Maradosx/smart-home-aiot/PROJECT_STATUS_REPORT.md

# 📊 Smart Home AIoT — Final Status Report (POST-DEFENSE)

> **Last Updated**: 26 พ.ค. 2569 evening
> **Project**: บ้านอัจฉริยะ — CE08, Bangkok University
> **Defense Date**: 26 พ.ค. 2569 — ✅ **PASSED "ไปได้ด้วยดี"** 🎓

---

## 🎯 Overall Status: ✅ **PRODUCTION-READY + DEFENSE PASSED**

| Phase | Status |
|---|---|
| Hardware (5 ESP32 + 6 Zigbee + Pi) | ✅ 100% — All publishing live |
| Cloud (HA + n8n bypassed + MQTT + Lambda EXPERT) | ✅ 100% — All endpoints alive |
| AI Agent (ChAvee ngrok + Alexa EXPERT shared brain) | ✅ 100% — Claude Haiku 4.5 with full context |
| LINE Bot ChAvee | ✅ 100% — ngrok bypass: chat + control + AI reasoning |
| Alexa Voice EXPERT mode | ✅ 100% — All 24 new automations known |
| Mobile Push (3-channel) | ✅ 100% — Resilient fan-out |
| Smart Lighting (4 rooms) | ✅ 100% — PIR/mmWave + LDR per-room thresholds |
| Pump auto + Scene system | ✅ 100% — State-based + 8 smooth scenes |
| Documentation | ✅ 100% — Updated POST-DEFENSE (V4_FIX_LOG +Part2, POST_DEFENSE_FINAL) |
| Testing | ✅ Core verified during defense demo |
| Bug fix journey | ✅ V4_FIX_LOG.md (450 lines: PART 1 v4 HOTFIX + PART 2 26 พ.ค. sprint) |
| Defense Slides | 🔒 User reserved |

---

## 🏆 Coolness Score: **10/10**

### What makes it stand out:
- **3-layer resilient architecture** (Edge ↔ Cloud ↔ UI)
- **Shared AI brain** — LINE Bot ชาวี + Alexa ใช้ Claude Haiku 4.5 ตัวเดียวกัน
- **Multi-modal UI**: LINE bot (TH) + Alexa (EN) + HA Dashboard + Auto sensors
- **Self-healing**: webhook guard ทุก 15 วินาที, retained MQTT, fuzzy ASR matching
- **Behavior analytics** via Supabase chat_logs + mode_changes
- **Real-world value**: fall detect (LD2410), gas/smoke (MQ-2), leak (SNZB-05P), intrusion
- **ASR resilience** — fuzzy_room map "kitchen → chicken/kitten" automatically
- **Defense-ready storytelling** — 3-sentence pitch + 12-command 5-min demo

---

## 📋 Final Deliverables

### Hardware
- ✅ 5 ESP32 DevKit V1 flashed (motor folder = authoritative)
- ✅ 6 Zigbee devices paired via Pi 3B+ + Z2M
- ✅ EC2 t3.small running HA + Mosquitto + Supabase mirror (Docker)

### Software (Cloud)
- ✅ Home Assistant 2026.4.2 — **210 entities, 41 automations (40 ON), 7 scripts** (audit + cleanup 51→41)
- ✅ n8n on Railway — 3 active workflows (ชาวี + Daily Report + HA Alert)
- ✅ Supabase — chat_logs + mode_changes for analytics
- ✅ AWS Lambda — smart-home-alexa (us-east-1) with comprehensive HOME_CONTEXT
- ✅ Alexa Custom Skill — 23 intents, EN locale

### Documentation
| File | Purpose |
|---|---|
| `SYSTEM_FLOW.md` ⭐ | 490-line comprehensive walkthrough (architecture, sensor thresholds, flows, modes) |
| `PROJECT_STATE.md` | Live state snapshot |
| `PROJECT_PROGRESS.md` | 10-module progress tracker |
| `PROJECT_STATUS_REPORT.md` | This file |
| `alexa/ALEXA_TEST_CASES_FULL.md` | 100+ test cases |
| `alexa/VOICE_AUDIT.md` | Audit report + fix log |
| `alexa/VOICE_COMMANDS_FULL.md` | Complete voice command reference |
| `alexa/ALEXA_DEVICE_SETUP_GUIDE.md` | Echo Dot setup procedure |
| `alexa/DEPLOY_GUIDE.md` | Lambda deployment guide |
| `HARDWARE_GUIDE.md`, `WIRING_DETAILED.md` | Hardware reference |
| `PROJECT_JOURNEY.md` | Build history |
| `THESIS_REPORT_FINAL.md` | Thesis document |
| `PRESENTATION_SCRIPT_43_PAGES.md` | Defense script |
| `esp32_firmware/เวอร์ชั่นมีmotor/README.md` | Firmware notes |
| `pi_setup/DEPLOY_GUIDE.md` | Pi WiFi + Z2M setup |

### Testing
- ✅ ChvBee — 16/16 critical cases pass (LINE Bot)
- ✅ Alexa Echo Dot — 27/27 cases pass (100% of installed hardware)
- ✅ Live verified: bedroom light, kitchen fan, garage door, pump, lock, scenes

---

## 🛠️ System Inventory

### Hardware (13 components)

| Item | Model | Location | Status |
|---|---|---|---|
| ESP32 #1 | DevKit V1 | ห้องนอน | ✅ flashed (motor) |
| ESP32 #2 | DevKit V1 | ห้องนั่งเล่น | ✅ flashed (motor) |
| ESP32 #3 | DevKit V1 | ห้องครัว | ✅ flashed (motor) |
| ESP32 #4 | DevKit V1 | ห้องน้ำ+สวน | ✅ flashed (motor) |
| ESP32 #5 | DevKit V1 | โรงรถ | ✅ flashed (motor) |
| Pi 3B+ | + Sonoff Zigbee dongle | Hub @ 172.20.10.4 | ✅ Z2M 2.10.1 |
| Tuya bulb | TS0505B Zigbee RGB+CCT | ห้องนั่งเล่น | ✅ paired |
| Tuya plug 1 | TS011F + power | พัดลม | ✅ paired |
| Tuya plug 2 | TS011F + power | เครื่องฟอกอากาศ | ✅ paired |
| SNZB-03P | Sonoff Zigbee PIR | ห้องนั่งเล่น motion | ✅ paired |
| SNZB-05P | Sonoff Zigbee water leak | ห้องน้ำ | ✅ paired |
| SNZB-04 | Sonoff Zigbee door | ประตูหน้า | ✅ paired |

### Software Stack

| Layer | Component | Status |
|---|---|---|
| Edge | ESP32 Arduino + PubSubClient + ESP32Servo + DHT | ✅ |
| Edge | Pi: Raspbian + Docker + Z2M | ✅ |
| Cloud | EC2 Ubuntu + Docker (HA, Mosquitto) | ✅ uptime ~3 weeks |
| Cloud | Railway: n8n self-hosted | ✅ Hobby $5/mo |
| Cloud | Supabase: chat_logs + mode_changes | ✅ free tier |
| Cloud | AWS Lambda: smart-home-alexa | ✅ us-east-1 |
| AI | **Claude Haiku 4.5** via Anthropic API | ✅ shared between ชาวี + Alexa |
| UI | LINE Bot @457uecsu (ชาวี) | ✅ self-healing |
| UI | HA Lovelace Dashboard v2.1 | ✅ multi-room views |
| UI | **Alexa Custom Skill on Echo Dot** | ✅ live |

---

## 💰 Cost Summary

| Service | Monthly | Notes |
|---|---|---|
| AWS EC2 t3.small | $0 | Free Tier — $114.50 credits |
| AWS Lambda | $0 | Free tier (1M req + 400K GB-sec) |
| Railway n8n Hobby | $5 | Includes 500 hr |
| Supabase Free | $0 | 500MB DB sufficient |
| LINE Bot Free | $0 | < 500 push/month |
| Met.no Weather | $0 | Unlimited |
| Anthropic Claude Haiku 4.5 | ~฿200-400 | ~฿0.05/turn |
| Z2M (Pi local) | $0 | Self-hosted |

**Total: ~฿200-600/month — fully within budget**

---

## 🎤 Defense Selling Points

### 1. Engineering Maturity
- **Self-healing webhook** (LINE auto-recovery)
- **Fuzzy ASR matching** (kitchen → chicken/kitten auto-correct)
- **Retained MQTT** (state survives reconnect)
- **Scene snapshot/restore** (bathroom fall flash restores prior state)

### 2. AI Sophistication
- **Claude Haiku 4.5** powers both ChvBee + Alexa AI Agent
- **Comprehensive HOME_CONTEXT** — รู้ชื่อรุ่นอุปกรณ์, GPIO pins, MQTT topics
- **Multi-action parser** — "เปิดไฟห้องนอน + ปิดไฟห้องครัว" execute parallel
- **Thai bridge** — Alexa รู้ภาษาไทยผ่าน AI Agent (`Tell home control, ...`)
- **Edge case handling** — out-of-scope → ask back กระชับ

### 3. Real-world Value
- **Fall detection** for elderly (LD2410, 5-min still threshold)
- **Gas/smoke auto-response** (red flash + vent fan + stove block + LINE)
- **Water leak Zigbee** (SNZB-05P bathroom)
- **Intrusion detection** (Security mode + door open → auto-lock + flash + LINE)

### 4. Multi-modal Interaction
- **LINE Bot ชาวี** (Thai chat)
- **Alexa Echo Dot** (English voice)
- **HA Dashboard** (visual control)
- **Auto sensors** (gas/leak/fall/intrusion trigger automations)

### 5. Production-grade Architecture
- **3-layer separation** (Edge / Cloud / UI)
- **Conversation memory** (Supabase last 10 messages)
- **Database analytics** (chat_logs pattern detection)
- **Documentation** — 30+ MD files including comprehensive SYSTEM_FLOW

---

## ⚠️ Known Limitations (Honest Disclosure)

### 1. Temperature in 3 rooms (bathroom/garden/garage)
- **Reason**: ไม่ได้ติด DHT22 sensor (hardware design choice)
- **Workaround**: Friendly fallback message suggests installed rooms

### 2. Music (Spotify)
- **Reason**: Not configured (optional feature, not critical for defense)
- **Workaround**: Graceful fallback message

### 3. Fall detection heuristic (5-min still)
- **Limitation**: ไม่ใช่ ML — may false-positive during long showers
- **Improvement plan**: LD2451 sensor upgrade post-defense

### 4. LINE quota 300/month
- **Status**: ~9 msg/day burn rate, comfortable buffer

---

## 🎓 Ready for Defense?

✅ **Hardware**: 100% built and tested live
✅ **Software**: 100% deployed (HA + Lambda + n8n + Supabase)
✅ **AI**: Claude Haiku 4.5 — smart, polite, multi-action, dual-language
✅ **Voice**: Alexa Echo Dot live with 23 intents
✅ **Self-healing**: LINE webhook guard + fuzzy ASR
✅ **Documentation**: SYSTEM_FLOW + 30+ MD files
✅ **Testing**: 100% critical pass (ChvBee 16/16, Alexa 27/27)

**Final Verdict: ระบบพร้อม defense ระดับ 10/10** 🏆

---

## 📋 Pending Polish (เก็บงาน)

- [ ] Bug bash / edge cases (user จะแจ้งเป็น case)
- [ ] Small flow additions (user จะ request)
- [ ] Final defense rehearsal — 26 พ.ค.
