Maradosx/smart-home-aiot/DEFENSE_HANDOFF/DEFENSE_DAY_FINAL_STATUS.md

# 🎓 DEFENSE DAY FINAL STATUS — 26 พ.ค. 2569

# 🏆 DEFENSE PASSED — "ไปได้ด้วยดีเลยครับ" 🎉

**Owner:** Athit "Mos" Boonpinit
**Project:** Smart Home AIoT (Bangkok University Senior Project CE08)
**Defense Date:** 26 พ.ค. 2569 (Tuesday)
**Result:** ✅ **PASSED — สำเร็จ**

---

## 🎯 Final System Status (Post-Defense)

| Component | Status | Notes |
|---|---|---|
| 🏠 Home Assistant | ✅ Operational | 87 automations active |
| 🤖 ชาวี LINE Bot | ✅ FULL (via ngrok bypass) | Chat + Control + AI |
| 🎤 Alexa Echo Dot | ✅ Expert mode | All 23 new automations |
| 📱 Mobile Push | ✅ Active | 3-channel fan-out |
| 💡 Smart Lighting | ✅ 4 rooms | PIR/mmWave + LDR adaptive |
| 🌱 Auto Watering | ✅ State-based | 45% on, 60% off, 10min safety |
| 🎬 Scene System | ✅ 8 modes | Smooth switching |
| 📍 GPS Auto-Mode | ✅ Active | 4m radius, user location |
| 🚪 Front Door Lock | ✅ Servo | Lock/unlock via LINE/Alexa |
| 🔔 Safety Alerts | ✅ Gas/Water/Fall/Intrusion | CRITICAL push priority |
| 5️⃣ ESP32 Zones | ✅ All publishing MQTT | bedroom/living/kitchen/bathroom/garage |
| 6️⃣ Zigbee Devices | ✅ All paired | Tuya×3 + Sonoff×3 |
| 📡 Pi 3B+ Z2M | ✅ Stable | Long uptime |
| ☁️ EC2 + Lambda + n8n | ✅ All up | (n8n LINE bypassed via ngrok) |

---

## 🎬 Demo Verified Live (During Defense)

### Alexa Echo Dot:
- ✅ "Alexa, ask home control to turn on living room light"
- ✅ "Alexa, ask home control to set living room to red"
- ✅ "Alexa, ask home control to turn on party mode" (5-color loop)
- ✅ "Alexa, ask home control to open the garage"
- ✅ "Alexa, ask home control what's the temperature in kitchen"
- ✅ "Alexa, ask home control to set sleep mode"

### ChAvee LINE (via ngrok bypass):
- ✅ "สวัสดี" → Thai natural greeting
- ✅ "ทำอาหารปลอดภัยมั้ย" → AI checks gas + responds
- ✅ "เปิดไฟห้องนั่งเล่น" → Light ON
- ✅ "เปลี่ยนสีไฟเป็นน้ำเงิน" → Tuya color change
- ✅ "เปิดประตูโรงรถ" → Garage opens
- ✅ "เปิดโหมดปาร์ตี้" → Loop starts
- ✅ "ดึกแล้ว" → AI suggests Sleep mode

### HA Dashboard:
- ✅ All 8 scene buttons smooth switching
- ✅ All entity refs clean (0 yellow warnings)
- ✅ Smart Motion auto-light per room
- ✅ Pump auto on/off based on soil moisture

### Mobile Push (HA Companion):
- ✅ Mode change → instant push
- ✅ Gas alert → critical priority sound
- ✅ Door intrusion (Away) → critical alert

---

## 🐛 Bug-Fix Sprint Summary (12+ hours, 12 bugs + ChAvee bypass)

See [`POST_DEFENSE_FINAL.md`](POST_DEFENSE_FINAL.md) for full retrospective.

**Quick list:**
1. ✅ LINE quota 300/300 → Basic ฿1,284/mo
2. ✅ Notification SPOF → 3-channel
3. ✅ LDR direction (3 iterations) → HIGH=DARK
4. ✅ Override-detect misfire (disabled)
5. ✅ Pump time-based → state-based
6. ✅ Party loop architecture
7. ✅ Alert blink scene conflict
8. ✅ 12 dashboard refs broken
9. ✅ Stale entities disabled
10. ✅ Legacy adaptive_light broken
11. ✅ GPS zone radius + location
12. ✅ Comfort Mode → light auto
13. ✅ **BIG: ChAvee n8n control → ngrok HTTPS bypass**

---

## 🏆 What Made Defense Successful

### Technical Strengths Shown:
- **Multi-modal control** — voice (Alexa) + chat (LINE) + dashboard (HA)
- **AI reasoning** — Claude Haiku 4.5 shared between LINE + Alexa
- **Resilient architecture** — 3-channel notifications
- **State-based automation** — pump runs until target
- **Adaptive lighting** — PIR + mmWave + LDR per room
- **Safety automations** — gas/water/fall/intrusion + critical alerts
- **GPS-based mode** — auto Home/Away with 2-min grace

### Engineering Discipline:
- **Comprehensive testing** — 130 test cases × 10 trials
- **Documentation** — V4_FIX_LOG (450 lines), PROJECT_STATE, WORKFLOWS_AND_TESTING
- **Bug-fix journal** — every issue recorded
- **Backup mechanisms** — manual override, safety cutoff, mode-based

### Problem-Solving:
- **Never gave up** — 12+ hours straight bug-fix sprint
- **Iterative calibration** — LDR through 3 iterations
- **Pivot when blocked** — n8n impossible → ngrok bypass
- **User-centric** — listened to feedback, fixed per real testing

---

## 💝 Personal Note

ขอบคุณ user (Athit "Mos") ที่สู้ไปด้วยกัน 12+ ชั่วโมง:
- LINE quota หมด → upgrade plan
- LDR direction ผิด 3 รอบ → calibrate
- ChAvee LINE control พัง → "วนทำเรื่อยๆจนกว่าจะได้"
- จนสุดท้าย **PASSED** 🎓

นี่คือสปิริต engineer ที่แท้จริงครับ 💪✨

---

## 📚 Reading After Defense

1. [`POST_DEFENSE_FINAL.md`](POST_DEFENSE_FINAL.md) — Full retrospective ⭐
2. [`01_docs/PROJECT_STATE.md`](01_docs/PROJECT_STATE.md) — Current snapshot
3. [`01_docs/V4_FIX_LOG.md`](01_docs/V4_FIX_LOG.md) — Bug fix history
4. [`ALEXA_COMMANDS_DEFENSE.md`](ALEXA_COMMANDS_DEFENSE.md) — Alexa commands
5. [`CHAVEE_COMMANDS_DEFENSE.md`](CHAVEE_COMMANDS_DEFENSE.md) — ChAvee commands

---

# 🎉 CONGRATULATIONS! Senior Project Defended Successfully! 🎓
