Maradosx/smart-home-aiot/DEFENSE_HANDOFF/README.md

# 🎓 Defense Handoff — Smart Home AIoT

**Defense:** 26 พ.ค. 2569 — ✅ **PASSED ผ่านไปได้ด้วยดี** 🎉
**Status:** ✅ Production-ready Smart Home + 24 new automations + ChAvee ngrok bypass

🔥 **เริ่มที่นี่ก่อน:** [POST_DEFENSE_FINAL.md](POST_DEFENSE_FINAL.md) — สรุปครบทุกอย่าง 12+ ชั่วโมง bug-fix sprint + Defense PASSED

---

## 📁 Folder Structure (Post-cleanup 27 พ.ค.)

### 🏆 DEFENSE_HANDOFF/ Root — Final Bundle
- **`POST_DEFENSE_FINAL.md`** ⭐⭐⭐ — Comprehensive retrospective (THE main doc)
- `ALEXA_COMMANDS_DEFENSE.md` — Alexa command reference (60+ commands)
- `CHAVEE_COMMANDS_DEFENSE.md` — ChAvee LINE command reference (Thai natural language)
- `DEFENSE_DAY_FINAL_STATUS.md` — Defense day status + verified demo commands
- `README.md` — This file (entry point)
- `*.pdf` (4 files) — Defense presentation slides:
  - `MOOD_SCENES_LIGHT_EFFECTS_v2.pdf`
  - `NETWORK_DATAFLOW_v2.pdf`
  - `SOFTWARE_2slides_v2.pdf`
  - `WORKFLOWS_3slides_v2.pdf`

### `01_docs/` — Technical Verification Docs (post-cleanup: 2 unique files)
- `ALEXA_LAMBDA_VERIFY.md` — Alexa test verification guide (expert mode)
- `CHAVEE_ALEXA_UPDATE_STATUS.md` — Context update status (Lambda ✅, n8n bypassed via ngrok)

> 💡 **Note:** ในรอบ cleanup เอา sync duplicates ของ Project_1 root ออกแล้ว — main docs (PROJECT_STATE/PROGRESS/STATUS_REPORT/V4_FIX_LOG/HOME_FLOW_FINAL) ดูที่ `../` (Project_1 root) — single source of truth

### `02_test_sheets/` — Thesis Data Collection PDFs (10 files)
- `00_ALL_130_tests.pdf` ⭐ — Master (131 pages, 130 tests)
- `A_*` to `I_*` — Per-phase PDFs (8-40 pages each)

แต่ละ test มี:
- Test ID + Name + Phase
- Method + Expected
- ตาราง 10 trials (Trial#, Date, Time, Input, Actual Output, RT ms, P/F, Notes)
- Summary stats (Pass Rate / Avg RT / Std Dev) + Comments

### `03_scripts/` — Source Code
- `generate_test_sheets.py` — Python script ที่ใช้ generate PDFs (regenerate ได้ทุกเมื่อ)

---

## 📚 Main Docs Location (Project_1 root)

หลัง cleanup — main working docs อยู่ที่ **Project_1 root** (ไม่ต้องดูที่ DEFENSE_HANDOFF/01_docs/):

| File | Path |
|---|---|
| `PROJECT_STATE.md` | `../PROJECT_STATE.md` |
| `PROJECT_PROGRESS.md` | `../PROJECT_PROGRESS.md` |
| `PROJECT_STATUS_REPORT.md` | `../PROJECT_STATUS_REPORT.md` |
| `HOME_FLOW_FINAL.md` | `../HOME_FLOW_FINAL.md` |
| `V4_FIX_LOG.md` | `../V4_FIX_LOG.md` |
| `SYSTEM_FLOW.md` | `../SYSTEM_FLOW.md` |
| `THESIS_REPORT_FINAL.md` | `../THESIS_REPORT_FINAL.md` |

---

## 🎯 Reading Order (Post-Defense)

### For Comprehensive Understanding:
1. **`POST_DEFENSE_FINAL.md`** — Full story (12 bugs + fixes + architecture)
2. **`../PROJECT_STATE.md`** — Current system state
3. **`../V4_FIX_LOG.md`** — Bug fix journey (PART 1 + PART 2)
4. **`../HOME_FLOW_FINAL.md`** — Concise flow

### For Operations / Demo:
1. **`ALEXA_COMMANDS_DEFENSE.md`** — All Alexa commands
2. **`CHAVEE_COMMANDS_DEFENSE.md`** — All ChAvee commands
3. **`../SYSTEM_FLOW.md`** — Workflow + automation details (490-line ref)

### For Data Collection (Thesis):
1. Print PDFs from `02_test_sheets/`
2. Record 10 trials per test
3. Calculate statistics per sheet

---

## 🏆 Defense Outcome

✅ **PASSED — "ไปได้ด้วยดี"**

Demo verified end-to-end:
- 🎤 Alexa Echo Dot (Expert mode — all 24 new automations)
- 💬 ChAvee LINE Bot (via ngrok bypass — FULL control + AI reasoning)
- 🏠 HA Dashboard (8 scenes, all clean, no errors)
- 📱 Mobile Push notifications (3-channel resilient)
- 💡 Smart Lighting (4 rooms, motion + LDR based)
- 🌱 Auto Watering (state-based + safety cutoff)
- 📍 GPS Auto-Mode (4m radius, current location)
- 🚪 Front Door Servo Lock
- 🔔 Safety Alerts (gas, water, fall, intrusion)

---

## 🐛 Bug Sprint Summary (26 พ.ค. — 12+ hours)

12 major bugs encountered + ALL RESOLVED:

1. ✅ LINE quota 300/300 → Basic plan ฿1,284/mo (15k msg)
2. ✅ Single notification channel → 3-channel fan-out (8 automations)
3. ✅ LDR direction wrong (3 iterations) → HIGH=DARK, calibrated thresholds
4. ✅ Override-detect misfiring → disabled (will refine)
5. ✅ Pump time-based → state-based (45% on, 60% off, 10min safety)
6. ✅ Party loop no loop on HA → input_boolean executor pattern
7. ✅ Alert blink ค้างขาว → Smart Light scene-block conditions
8. ✅ 12+ "Entity not found" → bulk patch via WS + SCP
9. ✅ Stale entities → disabled 4
10. ✅ Legacy adaptive_light broken → disabled 4 (replaced)
11. ✅ GPS zone duplicate + 7m radius → single 4m at user location
12. ✅ Comfort Mode no light change → new automation

**Plus 1 BIG fix:** ChAvee n8n control broken → **ngrok HTTPS bypass to HA-native webhook** ✅

---

## 🚀 Production Readiness

System is **ready for personal long-term use**:
- 24/7 uptime (HA Docker auto-restart)
- Resilient notifications (3 channels)
- Safety automations (gas/water/fall/intrusion)
- Adaptive automation (LDR-based, motion-based)
- Voice control (Alexa)
- Mobile chat (ChAvee LINE via ngrok)
- Backup mechanisms (manual override, safety cutoff, mode-based)

---

## 📋 Long-Term Improvements (Optional)

- [ ] Replace ngrok with Cloudflare Tunnel (no URL changes on restart)
- [ ] Re-enable manual override with user-vs-automation context filter
- [ ] Music per mode (รอ user spec)
- [ ] Local LLM option (privacy + reduce API cost)
- [ ] Continuous testing — 130-test suite via PDF sheets
- [ ] Camera/security integration
- [ ] Energy monitoring + reports

---

## 🗄️ Archive

ไฟล์เก่า/ซ้ำซ้อนที่ archive ตอน cleanup 27 พ.ค. อยู่ที่:
`../_archive/26may_cleanup/` — ดู [`../_archive/26may_cleanup/README.md`](../_archive/26may_cleanup/README.md) สำหรับ manifest

---

## 💝 Credits

**Architect/Owner:** Athit "Mos" Boonpinit — Bangkok University Senior Project CE08
**Defense Date:** 26 พ.ค. 2569 (Tuesday)
**Result:** PASSED 🎓✨

ขอบคุณ user ที่ **ไม่ยอมแพ้** ตลอด bug-fix sprint 12+ ชั่วโมง — "วนทำเรื่อยๆจนกว่าจะได้"

นี่คือ Smart Home AIoT ที่ทำงานจริงๆ — ไม่ใช่ demo เฉพาะวันสอบ 💪
