Maradosx/smart-home-aiot/DEFENSE_HANDOFF/CHAVEE_COMMANDS_DEFENSE.md

# 💬 ChAvee LINE Bot — Defense Day Command List
**Bot:** Smart Home Bot (@457uecsu) | **Plan:** Basic 15,000 msg/month

> ChAvee เป็น AI ภาษาไทยธรรมชาติ — พูดคุยแบบเพื่อนได้ ไม่ต้องตามรูปแบบเป๊ะ
> เปิด LINE → คุยกับ "Smart Home Bot"

---

## 👋 ทักทาย + คุยเล่น

- "สวัสดี"
- "ฮัลโหล"
- "ChAvee เหรอ"
- "เป็นไงบ้างวันนี้"
- "ขอบคุณนะ"

---

## 📊 ถามสถานะบ้าน

### โดยรวม
- "**สถานะบ้านตอนนี้เป็นยังไง**"
- "ทุกอย่างปลอดภัยมั้ย"
- "เกิดอะไรขึ้นในบ้านบ้าง"
- "สรุปสถานะให้ฟังหน่อย"

### อุณหภูมิ + ความชื้น
- "อุณหภูมิห้องนั่งเล่นเท่าไหร่"
- "ห้องนอนร้อนมั้ย"
- "ห้องครัวอากาศเป็นยังไง"
- "ความชื้นห้องน้ำเท่าไหร่"

### แสง
- "ห้องนั่งเล่นมืดมั้ย"
- "แสงในห้องนอนเป็นยังไง"

### แก๊ส + อากาศ
- "**ทำอาหารปลอดภัยมั้ย**" (ChAvee จะเช็ค gas ก่อนตอบ — เป็นจุดเด่นของ AI reasoning)
- "มีแก๊สรั่วมั้ย"
- "อากาศห้องนั่งเล่นเป็นยังไง"

### น้ำรั่ว / ความปลอดภัย
- "มีน้ำรั่วมั้ย"
- "ประตูล็อคอยู่ป่ะ"
- "มีคนอยู่บ้านมั้ย"

### สวน / ปั๊ม
- "ดินสวนแห้งมั้ย"
- "ปั๊มน้ำเปิดอยู่ป่ะ"
- "ต้องรดน้ำต้นไม้มั้ย"

---

## 💡 ควบคุมไฟ

### ห้องนั่งเล่น (Tuya RGB)
- "**เปิดไฟห้องนั่งเล่น**"
- "ปิดไฟห้องนั่งเล่น"
- "**เปลี่ยนสีไฟเป็นสีฟ้า**"
- "เปลี่ยนสีไฟเป็นสีแดง"
- "เปลี่ยนสีไฟเป็นสีม่วง"
- "เปลี่ยนสีไฟเป็นสีเหลือง"
- "เปลี่ยนสีไฟเป็นสีเขียว"
- "ทำไฟให้หรี่หน่อย"
- "ทำไฟให้สว่างขึ้น"
- "เพิ่มความสว่างเป็น 50%"
- "ไฟห้องนั่งเล่นเขียวกว่านี้"
- "ตั้งเป็นโทนอุ่นๆ"
- "ตั้งเป็นโทนเย็น"

### ห้องอื่น
- "เปิดไฟห้องนอน"
- "ปิดไฟห้องครัว"
- "เปิดไฟห้องน้ำ"
- "ปิดไฟทั้งบ้าน"
- "เปิดไฟทุกห้อง"

---

## 🌬️ พัดลม + เครื่องฟอกอากาศ

- "เปิดพัดลมห้องนั่งเล่น"
- "ปิดพัดลม"
- "เปิดพัดลมห้องนอน"
- "เปิดเครื่องฟอกอากาศ"
- "ปิดเครื่องฟอก"

---

## 🚪 ประตู + โรงรถ

- "ล็อคประตูหน้า"
- "**ปลดล็อคประตู**"
- "เปิดประตูโรงรถ"
- "ปิดประตูโรงรถ"
- "**เปิดม่านห้องนอน**"
- "ปิดม่านห้องนอน"

---

## 🌱 ปั๊มน้ำสวน

- "เปิดปั๊มน้ำ"
- "ปิดปั๊มน้ำ"
- "รดน้ำต้นไม้ให้หน่อย"
- "เปิดไฟสวน"

---

## 🎬 Scene / โหมด (Living Room Modes)

### Living Room Scenes
- "**เปิดโหมดปาร์ตี้**" → ไฟ loop 5 สี (pink/cyan/yellow/purple/green)
- "ปิดปาร์ตี้"
- "**เปิดโหมดต้อนรับ**" → ส้มอุ่น
- "เปิด Sunrise scene" → แดดเช้า
- "เปิดสีฟ้านุ่ม" → calm
- "เปิดโหมดนอน" → แดงสลัว
- "เปิด alert" → blink red

### House Modes (Home/Away/Security)
- "ผมจะออกจากบ้าน" → ChAvee เปลี่ยนเป็น Away mode
- "ผมกลับมาแล้ว" → Home mode
- "เปิดโหมด security"
- "เปิดโหมด away"

### Comfort Modes
- "ผมจะนอนแล้ว" → Sleep mode (ปิดไฟ + ปิดม่าน + พัดลม)
- "ดึกแล้ว" → ChAvee เสนอ Sleep mode
- "เปิดโหมด Relax"
- "เปิดโหมด Warm"

---

## 🧠 AI Reasoning (จุดเด่น ChAvee — Mood-aware + Multi-action)

ChAvee อ่านอารมณ์ + เดาความต้องการ:

### อารมณ์ผู้ใช้
- "**ร้อนจัง**" → ChAvee เสนอเปิดพัดลม + ปรับสีไฟเย็น
- "**มืดจัง**" → เสนอเปิดไฟ
- "**เหม็น**" → เสนอเปิดเครื่องฟอกอากาศ
- "**บ้านดูยุ่งเหยิงจัง**" → เสนอ Relax scene (warm + dim + พัดลมเบา)
- "**เหนื่อยมาก**" → เสนอ Sleep mode
- "**หิว**" → เช็ค gas → "เตาแก๊สปลอดภัยครับ ทำอาหารได้เลย"

### Multi-action
- "**ไปนอน**" → ChAvee ปิดไฟทั้งบ้าน + ปิดพัดลม + ปิดม่านห้องนอน
- "**ออกจากบ้าน**" → ปิดทุกอุปกรณ์ + ล็อคประตู + เปิด Away mode
- "**ทำให้อบอุ่น**" → Comfort Relax + Tuya warm + ปิดม่าน (ถ้ากลางคืน)
- "**ทำให้ตื่นตัว**" → Cool tone + bright + เปิดเครื่องฟอก

### Confirmation (ChAvee ขออนุญาตก่อนทำ destructive)
- "ปิดทุกอย่าง" → "ปิดไฟ + พัดลมทุกห้องนะครับ? ตอบ ใช่ เพื่อยืนยัน"

---

## 🆘 Emergency Commands

- "**มีคนบุก!**" → ChAvee ล็อคประตู + Security mode + flash แดง + LINE alert
- "**ช่วยด้วย!**"
- "ฉุกเฉิน"
- "มีแก๊สรั่ว"

---

## ❓ ถามเกี่ยวกับระบบ

- "ChAvee ทำอะไรได้บ้าง"
- "มี automation อะไรบ้าง"
- "ปั๊มเปิดเมื่อกี่เปอร์เซ็นต์" (ChAvee จะตอบจาก context)
- "อุปกรณ์ทั้งหมดมีอะไรบ้าง"

---

## 💬 คุยเล่น (ChAvee ตอบได้แต่จะดึงกลับเรื่องบ้าน)

- "วันนี้อากาศดีนะ"
- "ฉันรู้สึกเหงา"
- "แนะนำหนังหน่อย" (ChAvee ตอบสั้น + แนะ scene ดูหนัง)

---

## 📍 Defense Demo Sequence — 5 ข้อความที่ทำให้ ChAvee ฉลาดสุด

1. **"สวัสดี"** → ทักทายแบบเป็นกันเอง + สรรพนาม "ผม/ครับ"
2. **"ทำอาหารปลอดภัยมั้ย"** → AI reasoning: เช็ค gas/อากาศ → ตอบสรุป
3. **"บ้านดูยุ่งเหยิงจัง"** → AI mood: เสนอ Relax scene + อธิบาย
4. **"เปลี่ยนสีไฟเป็นสีน้ำเงิน"** → control + reply confirmation
5. **"ดึกแล้ว"** → time-aware: เสนอ Sleep mode + ขอ confirm

หรือ:
1. "สถานะบ้านตอนนี้" → รายงานครบทุกห้อง
2. "เปิดโหมดปาร์ตี้" → loop 5 สี
3. "ปิดปาร์ตี้"
4. "ผมจะออกไปข้างนอก" → Away mode
5. "ผมกลับมาแล้ว" → Home mode + welcome scene

---

## 💡 Tips for Defense
- ChAvee ใช้เวลาตอบ ~5-10 วินาที (n8n → Claude AI → reply)
- ตอบเป็นภาษาไทยเสมอ + emoji
- รู้ context ของอุปกรณ์ที่ paired ทั้งหมด (HA + Z2M + ESP32)
- **ถ้า ChAvee ตอบช้า** อาจเป็น Claude API throttle — รอเฉยๆ
- ChAvee + Alexa **แชร์ AI brain เดียวกัน** (Claude Haiku 4.5)
