Maradosx/smart-home-aiot/DEFENSE_HANDOFF/01_docs/CHAVEE_ALEXA_UPDATE_STATUS.md

# 📊 ChAvee + Alexa Expert Mode — FINAL STATUS (Post-Defense)

## ✅ BOTH FULLY OPERATIONAL

### 🎤 Alexa Lambda — EXPERT MODE
- **HOME_CONTEXT** comprehensive (242 lines, 16KB) ใน lambda_function.py
- Includes: 5 ESP32 zones, 6 Zigbee devices, 24 NEW automations, 5 input_buttons, 6 input_booleans, 5 Scene Smart, 3 notification channels, thresholds, intent patterns
- **lambda.zip** uploaded to AWS Lambda (us-east-1) by user ✅
- **Verified during defense:** All 8+ commands work end-to-end

### 💬 ChAvee LINE — Via ngrok HTTPS Bypass ⭐
- **Issue:** n8n workflow body update blocked by Railway 401 cookie bug
- **Resolution:** Bypass n8n entirely via ngrok HTTPS tunnel
- **Architecture:**
  ```
  LINE → ngrok HTTPS tunnel → HA-native webhook automation 
        → Anthropic API (fresh context every call)
        → execute HA services (real, no hallucination)
        → LINE Push reply
  ```
- **Verified during defense:** Chat + Control + AI reasoning all work
- **Advantage:** Anthropic gets fresh state every call — always knows latest automations

---

## 🎓 Defense Result: ✅ PASSED

Both AI interfaces demonstrated successfully:
- Alexa Echo Dot — Expert mode, all device control
- ChAvee LINE — Thai natural language, mood-aware, multi-action

System architecture is production-ready and battle-tested.

---

## 📚 Reference Files
- [`../POST_DEFENSE_FINAL.md`](../POST_DEFENSE_FINAL.md) — Full retrospective (12 bugs + ngrok bypass)
- [`../ALEXA_COMMANDS_DEFENSE.md`](../ALEXA_COMMANDS_DEFENSE.md) — 60+ Alexa commands
- [`../CHAVEE_COMMANDS_DEFENSE.md`](../CHAVEE_COMMANDS_DEFENSE.md) — Thai ChAvee commands
