Maradosx/smart-home-aiot/docs/manual/index.html

🏠 SMART HOME AIoT · คู่มือบ้านฉบับสมบูรณ์

# คู่มือบ้านอัจฉริยะ

ระบบบ้านอัจฉริยะแบบ 3 ชั้น — ควบคุมด้วยเสียง (Alexa), แชต (ชาวี/LINE) และระบบอัตโนมัติที่ขับเคลื่อนด้วย AI

โดย Athit "Mos" Boonpinit & Titipan "Peach" Kilnmakphol · Bangkok University CE08 · อัปเดต 23 มิ.ย. 2569

244

Entities ในระบบ

79

Automations (ทำงาน 70)

10

อุปกรณ์ควบคุมได้

2

ผู้ช่วย AI (เสียง+แชต)

ภาพรวมระบบ

## สถาปัตยกรรม 3 ชั้น

สมองกลางคือ Home Assistant บน AWS EC2 เชื่อมทุกอุปกรณ์ผ่าน MQTT — มี Claude Haiku 4.5 เป็นสมอง AI ที่ใช้ร่วมกันทั้ง LINE และ Alexa

#### 🧠 ชั้นสมอง (Cloud)

Home Assistant + Mosquitto MQTT + n8n บน AWS EC2 (Docker) · Claude Haiku 4.5 (AI) · Supabase (เก็บประวัติแชต) · Met.no (อากาศจริง)

#### 📡 ชั้นเชื่อมต่อ

ngrok tunnel ถาวร → LINE webhook · AWS Lambda → Alexa Skill "home control" · MQTT over WiFi

#### 🔌 ชั้นอุปกรณ์ (Edge)

ESP32 ×5 โซน (MQTT) · Raspberry Pi + Zigbee2MQTT (6 อุปกรณ์ Zigbee) · เซนเซอร์ mmWave / แก๊ส / น้ำรั่ว / ดิน / LDR

### 🔧 อุปกรณ์ที่ควบคุมได้ (Entities หลัก)

ประเภท | อุปกรณ์ | ชนิด/หมายเหตุ
💡 ไฟ | light.living_room_light | หลอด Tuya RGB+CCT 16 ล้านสี (เปลี่ยนสี/อุณหภูมิแสงได้)
💡 ไฟ | switch.bedroom/kitchen/bathroom_light | ไฟห้องนอน/ครัว/น้ำ (สวิตช์)
💨 พัดลม | switch.living_room/bedroom/kitchen_fan | พัดลม 3 ห้อง
🌫️ ฟอกอากาศ | switch.living_room_air_purifier | เครื่องฟอกอากาศ
🌱 สวน | switch.garden_water_pump, garden_lights | ปั๊มรดน้ำ + ไฟสวน
🚗 โรงรถ | cover.garage_door, switch.garage_light/pathway | ประตูโรงรถ + ไฟ
🪟 ม่าน/ล็อก | cover.bedroom_curtain, lock.front_door_lock | ม่านห้องนอน + ล็อกประตูหน้า
🎚️ โหมด | house_mode (Home/Away/Security) · comfort_mode (Normal/Relax/Warm/Sleep) | โหมดบ้าน + โหมดความสบาย

ระบบอัตโนมัติ

## Automation ทั้งหมด แยกตามหมวด

ทุกตัวระบุ เงื่อนไขจริง + ตัวเลขจริง ที่ใช้ในระบบ

💡

### ไฟอัจฉริยะ (Smart Lighting)

4 ห้อง × 3

#### เปิดไฟอัตโนมัติ

มีคน + ห้องมืดพอ → เปิดไฟให้เอง (ห้องนอน/นั่งเล่น/น้ำ/โรงรถ)

เงื่อนไขมีคน (PIR/mmWave) และ ค่าแสง LDR เกินเกณฑ์มืด

เกณฑ์มืดนอน/นั่งเล่น/โรงรถ LDR > 2800 · ห้องน้ำ > 2200

กันไว้ไม่เปิดถ้า: กดสวิตช์เอง / โหมด Away·Security·Sleep / มีสัญญาณเตือน

#### ปิดไฟอัตโนมัติ

ไม่มีคนในห้อง → ดับไฟเอง

เงื่อนไขไม่มีคน 5 นาที → ปิด

#### กดสวิตช์เอง (Manual Override)

กดปิด/เปิดไฟเอง → ระบบจะไม่แทรกแซง

ทำงานกดสวิตช์เอง → ล็อกไม่ให้ auto 30 นาที

คืนค่าครบ 30 นาที → กลับเป็นอัตโนมัติเอง

#### ห้องครัว

ใช้สวิตช์มือ/สั่งด้วยเสียง·แชต — ไม่มี auto-on (ตามดีไซน์)

🌡️

### อุณหภูมิ & พัดลม (Climate)

4

Automation | เปิดเมื่อ | ปิดเมื่อ
พัดลมตามอุณหภูมิ (ทั่วไป) | นั่งเล่น > 30°C + อยู่บ้าน | นั่งเล่น < 28°C (กันกระพริบ)
โหมด Relax | Relax + นั่งเล่น > 28°C | —
โหมด Sleep — พัดลมห้องนอน | Sleep + ห้องนอน > 27°C | ห้องนอน < 25°C
เครื่องฟอกอากาศ | เซนเซอร์อากาศแจ้งเตือน (AQI แย่) | อากาศกลับดี (เฉพาะอยู่บ้าน)

💡 ไม่มีแอร์ในบ้าน — ระบบจึงใช้พัดลม + ฟอกอากาศจัดการความสบาย · พัดลมใช้ hysteresis (เปิด/ปิดคนละเกณฑ์) กันการกระพริบ

🌱

### สวน & ปั๊มรดน้ำ (Garden)

4

#### ปั๊มอัจฉริยะ (ตามดิน)

เปิดดินแห้ง < 45% + กลางวัน + ไม่ฝน (เช็คอากาศจริง)

ปิดดินชุ่ม > 60%

นิรภัยปั๊มทำงานเกิน 10 นาที → ตัดอัตโนมัติ + แจ้งเตือน

#### รดน้ำเช้า 07:00

รดน้ำตอนเช้า — แต่เฉพาะถ้าจำเป็น

เงื่อนไข07:00 + ดิน < 50% + ไม่ฝน → ปั๊ม 10 วินาที

ข้ามถ้าดินเปียก/ฝนตก = ไม่รด (กันสิ้นเปลือง)

🏠

### โหมดบ้าน (House Modes)

3

โหมด | ทำอะไร
🏠 Home | ใช้งานปกติ — ไฟอัตโนมัติทำงานเต็มที่
🚪 Away | ปิดไฟ/พัดลม/ปลั๊กทุกตัว + ล็อกประตูหน้า + ปิดประตูโรงรถ + ปิดไฟสวน
🛡️ Security | เหมือน Away + ปิดโรงรถ + ล็อกประตู (โหมดเฝ้าระวัง)
😴 Sleep (comfort) | ปิดไฟทุกดวง + ปิดม่านห้องนอน + คุมพัดลมห้องนอนตามอุณหภูมิ

📍

### GPS อัตโนมัติ (Presence)

2

#### กลับถึงบ้าน

เงื่อนไขGPS เข้าเขตบ้าน (ต้องเคย Away) + หน่วง 30 วินาที กันสัญญาณเด้ง

ทำเปิดโรงรถ + เปิดไฟภายนอก (ถ้ามืด) + ตั้งโหมด Home

#### ออกจากบ้าน

เงื่อนไขออกนอกเขตบ้านเกิน 2 นาที

ทำตั้งโหมด Away อัตโนมัติ (→ ปิดทุกอย่าง+ล็อก)

🚪

### ประตู โรงรถ ล็อก

3

Automation | เงื่อนไข → การทำงาน
ประตูหน้าไม่ล็อกนาน | ไม่ล็อก 10 นาที (อยู่บ้าน) → เตือน LINE
โรงรถปิดอัตโนมัติ | เปิดค้าง 5 นาที (อยู่บ้าน) → ปิดเอง
ตรวจจับบุกรุก | ประตูเปิดตอนโหมด Away/Security → เตือน LINE + มือถือ

🚨

### ความปลอดภัย (Safety)

6+

เหตุการณ์ | การตอบสนอง
🔥 แก๊สรั่ว (ครัว) | เปิดพัดลมระบาย + ไฟแดงกระพริบ + แจ้ง LINE + มือถือ
💧 น้ำรั่ว (ห้องน้ำ) | แจ้ง LINE + มือถือ + ไฟแดง
🤕 คนล้ม (ห้องน้ำ/ห้องนอน) | เรดาร์จับนิ่งเกิน 5 นาที → แจ้ง LINE + มือถือ (ดูวิธีจับด้านล่าง)
💨 ควัน (โรงรถ) | แจ้ง LINE
🍳 เตาทิ้งไว้ | เปิดค้าง 10 นาที (มีคนในบ้าน) → เตือน · 15 นาที (Away) → ตัดอุปกรณ์ + แจ้ง

🌅

### ตามเวลา & ม่าน (Schedule)

5

06:00

Sunrise Wake-up — ไฟค่อยๆ สว่าง 15 นาที (เฉพาะอยู่บ้าน)

07:00

Daily Report → สรุปอากาศ/ในบ้านส่ง LINE · + รดน้ำเช้า (ถ้าดินแห้ง)

เช้า (หลัง sunrise +30 นาที)

เปิดม่านห้องนอนอัตโนมัติ

18:00

เปิดไฟสวน

พระอาทิตย์ตก

ปิดม่านห้องนอน

23:00

ปิดไฟทุกห้อง + ไฟสวน + แจ้ง LINE

🎬

### ซีนไฟ & เอฟเฟกต์ (Scenes)

8

ซีน | ผล
🎉 ปาร์ตี้ | วนสีไม่หยุด (มีนิรภัยตัดที่ 30 นาที)
🚨 สัญญาณแดง | กระพริบแดง 6 ครั้ง (เหตุฉุกเฉิน) · มีนิรภัยเคลียร์ที่ 10 นาที
💧 ฟ้าสงบ / 🌅 แสงเช้า / 🏠 ต้อนรับ | ซีนบรรยากาศ (สั่งจากปุ่ม/เสียง/แชต)
🎨 สีตาม comfort mode | Normal 4000K · Relax ส้มอุ่น · Warm 2700K · Sleep แดงสลัว 15%
🔄 reset_normal (กลับปกติ) | ปุ่มหยุดทุกอย่าง — หยุดทุกซีน/สัญญาณ + ไฟกลับ warm

🤖

### ผู้ช่วย AI & แจ้งเตือน

2 ช่อง

#### ชาวี (LINE · ไทย)

LINE → ดึงประวัติแชต 6 ข้อความ → Claude Haiku 4.5 → สั่งได้หลายอย่างพร้อมกัน + จำบทสนทนาได้ + ตอบ + บันทึก

#### Alexa (เสียง · อังกฤษ)

Echo Dot → AWS Lambda → 18 คำสั่งเร็ว + สมอง Claude ตัวเดียวกัน (ถามอะไรก็ได้)

#### แจ้งเตือน 2 ช่องทาง

เปลี่ยนโหมด · แก๊ส · น้ำรั่ว · ล้ม · บุกรุก · ปั๊ม · โรงรถ → ส่ง LINE + มือถือ (อย่างละ 1 ไม่ซ้ำ)

วิธีสั่งงาน

## คำสั่ง ชาวี (LINE) & Alexa (เสียง)

Alexa เรียกด้วย "Alexa, ask home control to ..." · ชาวีพิมพ์ภาษาไทยใน LINE ได้เลย

อยากให้ทำ | 🤖 ชาวี (พิมพ์ใน LINE · ไทย) | 🔊 Alexa (พูด · "Alexa, ask home control to…")
💡 ไฟ (Lights)
เปิด/ปิดไฟแต่ละห้อง | "เปิดไฟห้องนั่งเล่น" · "ปิดไฟห้องนอน" | "…turn on/off the living room light"
ไฟทุกดวง | "เปิดไฟทั้งบ้าน" · "ปิดไฟทั้งบ้าน" | "…turn on/off all the lights"
เปลี่ยนสีไฟ | "ไฟสีฟ้า" · "สีแดง" · "สีเขียว" · "สีม่วง" | "…set the light to blue / red / green"
หรี่ / ความสว่าง | "หรี่ไฟเหลือ 30%" | "…dim the light to 30 percent"
แสงอุ่น / ขาว | "ไฟ warm" · "ไฟขาว" | "…warm white / cool white"
💨 พัดลม & อากาศ (Climate)
พัดลม (3 ห้อง) | "เปิดพัดลมห้องนอน" · "ปิดพัดลมห้องนั่งเล่น" | "…turn on the bedroom fan"
เครื่องฟอกอากาศ | "เปิดเครื่องฟอกอากาศ" | "…turn on the air purifier"
🌱 สวน (Garden)
ปั๊มรดน้ำ | "รดน้ำต้นไม้" · "เปิดปั๊มน้ำ" | "…turn on the water pump"
ไฟสวน | "เปิดไฟสวน" · "ปิดไฟสวน" | "…turn on the garden lights"
🚪 ประตู · โรงรถ · ม่าน · ล็อก
ประตูโรงรถ | "เปิดประตูโรงรถ" · "ปิดประตูโรงรถ" | "…open/close the garage door"
ม่านห้องนอน | "เปิดม่าน" · "ปิดม่าน" | "…open/close the curtain"
ล็อก / ปลดล็อกประตูหน้า | "ล็อคประตู" · "ปลดล็อคประตู" | "…lock / unlock the front door"
🏠 โหมดบ้าน (Modes)
โหมดบ้าน | "โหมด home" · "away" · "security" | "…set mode to home / away / security"
โหมดความสบาย | "โหมดพักผ่อน" · "อุ่น" · "นอน" · "ปกติ" | "…set comfort to relax / warm / sleep / normal"
🎬 ซีนไฟ (Scenes)
ปาร์ตี้ | "เปิดโหมดปาร์ตี้" | "…start party mode"
แสงเช้า / ฟ้าสงบ / ต้อนรับ | "ซีนแสงเช้า" · "ไฟฟ้าสงบ" · "ซีนต้อนรับ" | "…sunrise / calm / welcome scene"
🔄 หยุดทุกอย่าง / กลับปกติ | "กลับปกติ" | "…reset everything"
📊 สอบถามสถานะ (Status)
อุณหภูมิ | "อุณหภูมิห้องนอนเท่าไหร่" | "…what's the temperature in the bedroom"
ความชื้น | "ความชื้นเท่าไหร่" | "…what's the humidity"
แก๊ส / ความปลอดภัย | "แก๊สรั่วไหม" · "ปลอดภัยไหม" | "…is the gas safe"
คุณภาพอากาศ | "อากาศเป็นไง" | "…what's the air quality"
ดินสวน | "ดินแห้งไหม" | "…what's the soil moisture"
ประตู / ล็อก | "ประตูล็อกไหม" | "…is the front door locked"
อะไรเปิดอยู่บ้าง | "มีอะไรเปิดอยู่บ้าง" | "…what's on"
🤖 ขั้นสูง (AI · Multi-action · Memory)
สั่งหลายอย่างพร้อมกัน | "เปิดไฟห้องนอนกับพัดลม" | "…turn on the bedroom light and fan"
พูดต่อเนื่อง (จำได้) | "เปิดไฟครัว" → "ปิดมัน" | "…turn on the kitchen light" → "…turn it off"
คุยเล่น / ถามอะไรก็ได้ | "วันนี้อากาศเป็นไง" | "…how's everything at home"

💬 ชาวีตอบไทย · Alexa ตอบอังกฤษ (สมอง Claude ตัวเดียวกัน) · สั่งงานครั้งเดียวได้หลายอย่าง และจำสิ่งที่คุยก่อนหน้าได้ (เช่น "ปิดมัน" จะเข้าใจว่าหมายถึงอะไร)

เจาะลึก

## วิธีจับ "คนล้ม" และ "คนอยู่ในห้อง"

#### 📡 เซนเซอร์: LD2410C mmWave Radar

ห้องน้ำและห้องนอนใช้ เรดาร์คลื่นความถี่ mmWave (ต่อ ESP32 ผ่าน UART) — ต่างจาก PIR ตรงที่ จับคนที่อยู่นิ่งได้ (ไม่ต้องขยับ) เรดาร์รายงานสถานะ 4 แบบ: 0=ไม่มีคน · 1=มีคนขยับ · 2=มีคนอยู่นิ่ง · 3=ทั้งขยับ+นิ่ง · อ่านค่าทุก 500 มิลลิวินาที

#### 👤 คนอยู่ในห้อง (Presence)

เงื่อนไข: state ≠ 0 = มีคน (ขยับหรือนิ่งก็นับ)

เพราะ mmWave จับคนนิ่งได้ → รู้ว่ามีคนนอนอยู่บนเตียงแม้ไม่ขยับ (PIR ทำไม่ได้)

#### 🤕 คนล้ม (Fall)

ตรรกะเจอคน "อยู่นิ่งสนิท" (state 2 เท่านั้น) ต่อเนื่อง

เกณฑ์นิ่งเกิน 5 นาที → แจ้งเตือน "ล้ม"

รีเซ็ตถ้าขยับ (1/3) หรือออกจากห้อง (0) → ล้างตัวจับเวลา

🧠 หลักการ: คนปกติจะขยับตัวเล็กน้อยทุกไม่กี่นาที — ถ้าเรดาร์เห็นคน "นิ่งสนิทไม่ขยับเลย" นานเกิน 5 นาที สันนิษฐานว่าอาจล้ม/หมดสติ จึงแจ้งเตือน · ใช้หลักการเดียวกันทั้งห้องน้ำและห้องนอน

ตรวจรับ

## เช็คลิสต์ทดสอบ — ให้บ้านทำงาน 100%

ไล่ติ๊กทีละข้อ ก่อนใช้งานจริง/พรีเซนต์

A · 🤖 ชาวี (LINE)

1

"เปิดไฟห้องนั่งเล่น" → ไฟติด + ตอบกลับ

2

"ไฟสีฟ้า" → หลอดเปลี่ยนเป็นฟ้า

3

"เปิดไฟห้องนอนกับพัดลม" → ติดทั้งคู่ (สั่งหลายอย่าง)

4

"เปิดไฟครัว" แล้วต่อด้วย "ปิดมัน" → ปิดไฟครัวถูก (จำบทสนทนา)

5

"กลับปกติ" → หยุดทุกซีน + ไฟกลับ warm

6

"อุณหภูมิห้องนอนเท่าไหร่" → ตอบค่าจริง

7

"เปิดแอร์" → ตอบว่า "บ้านไม่มีแอร์" (ไม่มั่ว)

B · 🔊 Alexa (เสียง)

8

"Alexa, ask home control to turn on the living room light" → ไฟติด

9

"...what's the temperature in the bedroom" → ตอบเป็นอังกฤษ

10

"...set mode to away" → ทุกอย่างดับ + ล็อก

11

ถาม free-form เช่น "...is it safe at home" → ตอบฉลาด (สมอง Claude)

C · 🖥️ Dashboard & มือถือ

12

เปิดเว็บ HA → ทุกการ์ดโหลดครบ ไม่มี "unavailable"

13

เปิดแอป HA มือถือ (ตั้ง URL http://<EC2-IP>:8123) → คุมได้

14

กดปุ่มไฟ/พัดลม/โหมดใน dashboard → อุปกรณ์จริงเปลี่ยน

D · 🏠 ระบบอัตโนมัติ

15

เดินเข้าห้องตอนมืด → ไฟติดเอง · กลางวันสว่าง → ไม่ติด

16

กดสวิตช์ปิดไฟเองตอนอยู่ในห้อง → ไฟอยู่นิ่ง 30 นาที ไม่เด้งติด

17

สั่ง Away → ไฟ/พัดลมดับ + ประตูล็อก + โรงรถปิด

18

สั่ง Sleep → ไฟดับ + ม่านปิด · ขยับบนเตียง → ไม่เด้ง

19

เปิดประตูโรงรถทิ้งไว้ 5 นาที → ปิดเอง

E · 🔌 Hardware

20

คุมหลอด Tuya + พัดลม Zigbee จาก HA → ทำงาน

21

ESP32 4 โซน (นั่งเล่น/ครัว/นอน/โรงรถ) → ค่าเซนเซอร์สดใน dashboard

22

เปลี่ยนแบต door sensor (CR2477) → เปิด-ปิดประตู contact เปลี่ยน

F · 🚨 ความปลอดภัย (ระวังของจริง)

23

จิ้มน้ำที่เซนเซอร์น้ำรั่ว → LINE เตือน + ไฟแดง

24

ทดสอบแก๊ส (จ่อเบาๆ) → ไฟแดง + พัดลมระบาย + LINE

25

นั่งนิ่งในห้องน้ำ >5 นาที → ทดสอบแจ้งเตือนคนล้ม

ภาคผนวก ก

## รายการ Entity ทั้งหมด (165)

ทุก entity จริงในระบบ (ดึงสดจาก Home Assistant) — จัดกลุ่มตามชนิด เลขเรียงต่อเนื่อง 1–165 · ไม่รวม automation (ดูภาคผนวก ข) · รวมทั้งระบบ = 165 + 79 = 244 entities

💡ไฟ (หลอดปรับสี) 1

1. light.living_room_lightไฟห้องนั่งเล่น / Living Room Light

🔌สวิตช์ (ไฟ/พัดลม/ปลั๊ก) 20

2. switch.bathroom_lightไฟห้องน้ำ / Bathroom Light
3. switch.bedroom_fanพัดลมห้องนอน / Bedroom Fan
4. switch.bedroom_lightไฟห้องนอน / Bedroom Light
5. switch.garage_lightไฟโรงรถ / Garage Light
6. switch.garage_lightsGarage Lights
7. switch.garage_pathway_lightไฟทางเดิน / Pathway Light
8. switch.garden_light_1ไฟสวน 1 / Garden Light 1
9. switch.garden_light_2ไฟสวน 2 / Garden Light 2
10. switch.garden_lightsGarden Lights
11. switch.garden_water_pumpปั๊มรดน้ำ / Garden Water Pump
12. switch.kitchen_fanพัดลมระบายอากาศครัว / Kitchen Fan
13. switch.kitchen_lightไฟครัว / Kitchen Light
14. switch.kitchen_stoveเตาแก๊ส / Kitchen Stove
15. switch.living_room_air_purifierLiving Room Air Purifier
16. switch.living_room_air_purifier_2living_room_air_purifier
17. switch.living_room_air_purifier_child_lockliving_room_air_purifier Child lock
18. switch.living_room_fanพัดลมห้องนั่งเล่น / Living Room Fan
19. switch.living_room_fan_child_lockliving_room_fan Child lock
20. switch.living_room_light_do_not_disturbliving_room_light Do not disturb
21. switch.zigbee2mqtt_bridge_permit_joinZigbee2MQTT Bridge Permit join

🪟ม่าน/ประตูโรงรถ 2

22. cover.bedroom_curtainม่านห้องนอน / Bedroom Curtain
23. cover.garage_doorประตูโรงรถ / Garage Door

🔒ล็อกประตู 1

24. lock.front_door_lockFront Door Lock

📊เซนเซอร์ค่า 75

25. sensor.backup_backup_manager_stateBackup Backup Manager state
26. sensor.backup_last_attempted_automatic_backupBackup Last attempted automatic backup
27. sensor.backup_last_successful_automatic_backupBackup Last successful automatic backup
28. sensor.backup_next_scheduled_automatic_backupBackup Next scheduled automatic backup
29. sensor.bathroom_ldrแสงห้องน้ำ / Bathroom Light Level
30. sensor.bathroom_water_leak_batterybathroom_water_leak Battery
31. sensor.bedroom_humidityความชื้นห้องนอน / Bedroom Humidity
32. sensor.bedroom_ldrแสงห้องนอน / Bedroom Light Level
33. sensor.bedroom_temperatureอุณหภูมิห้องนอน / Bedroom Temperature
34. sensor.front_door_sensor_batteryfront_door_sensor Battery
35. sensor.front_door_sensor_voltagefront_door_sensor Voltage
36. sensor.garage_ldrแสงโรงรถ / Garage Light Level
37. sensor.garage_smoke_lpgGarage Smoke LPG
38. sensor.garden_ldrแสงสวน / Garden Light Level
39. sensor.garden_soil_moistureความชื้นดิน / Garden Soil Moisture
40. sensor.garden_soil_rawGarden Soil Raw
41. sensor.kitchen_gas_lpgKitchen Gas LPG
42. sensor.kitchen_humidityความชื้นครัว / Kitchen Humidity
43. sensor.kitchen_ldrแสงครัว / Kitchen Light Level
44. sensor.kitchen_temperatureอุณหภูมิครัว / Kitchen Temperature
45. sensor.living_room_air_purifier_currentLiving Room Air Purifier Current
46. sensor.living_room_air_purifier_current_2living_room_air_purifier Current
47. sensor.living_room_air_purifier_energyLiving Room Air Purifier Energy
48. sensor.living_room_air_purifier_energy_2living_room_air_purifier Energy
49. sensor.living_room_air_purifier_powerLiving Room Air Purifier Power
50. sensor.living_room_air_purifier_power_2living_room_air_purifier Power
51. sensor.living_room_air_purifier_voltageLiving Room Air Purifier Voltage
52. sensor.living_room_air_purifier_voltage_2living_room_air_purifier Voltage
53. sensor.living_room_air_qualityคุณภาพอากาศห้องนั่งเล่น / Air Quality
54. sensor.living_room_fan_currentliving_room_fan Current
55. sensor.living_room_fan_current_2Living Room Fan Current
56. sensor.living_room_fan_energyliving_room_fan Energy
57. sensor.living_room_fan_energy_2Living Room Fan Energy
58. sensor.living_room_fan_powerliving_room_fan Power
59. sensor.living_room_fan_power_2Living Room Fan Power
60. sensor.living_room_fan_voltageliving_room_fan Voltage
61. sensor.living_room_fan_voltage_2Living Room Fan Voltage
62. sensor.living_room_humidityความชื้นห้องนั่งเล่น / Living Room Humidity
63. sensor.living_room_ldrแสงห้องนั่งเล่น / Living Room Light Level
64. sensor.living_room_temperatureอุณหภูมิห้องนั่งเล่น / Living Room Temperature
65. sensor.livingroom_pir_batterylivingroom_pir Battery
66. sensor.livingroom_pir_illuminationlivingroom_pir Illumination
67. sensor.livingroom_pir_voltagelivingroom_pir Voltage
68. sensor.maradosx_app_versionMaradosx App Version
69. sensor.maradosx_audio_outputMaradosx Audio Output
70. sensor.maradosx_battery_levelMaradosx Battery Level
71. sensor.maradosx_battery_stateMaradosx Battery State
72. sensor.maradosx_bssidMaradosx BSSID
73. sensor.maradosx_connection_typeMaradosx Connection Type
74. sensor.maradosx_geocoded_locationMaradosx Geocoded Location
75. sensor.maradosx_last_update_triggerMaradosx Last Update Trigger
76. sensor.maradosx_location_permissionMaradosx Location permission
77. sensor.maradosx_sim_1Maradosx SIM 1
78. sensor.maradosx_sim_2Maradosx SIM 2
79. sensor.maradosx_ssidMaradosx SSID
80. sensor.maradosx_storageMaradosx Storage
81. sensor.sun_next_dawnSun Next dawn
82. sensor.sun_next_duskSun Next dusk
83. sensor.sun_next_midnightSun Next midnight
84. sensor.sun_next_noonSun Next noon
85. sensor.sun_next_risingSun Next rising
86. sensor.sun_next_settingSun Next setting
87. sensor.testphone_app_versionTestPhone App Version
88. sensor.testphone_audio_outputTestPhone Audio Output
89. sensor.testphone_battery_levelTestPhone Battery Level
90. sensor.testphone_battery_stateTestPhone Battery State
91. sensor.testphone_bssidTestPhone BSSID
92. sensor.testphone_connection_typeTestPhone Connection Type
93. sensor.testphone_geocoded_locationTestPhone Geocoded Location
94. sensor.testphone_last_update_triggerTestPhone Last Update Trigger
95. sensor.testphone_location_permissionTestPhone Location permission
96. sensor.testphone_sim_1TestPhone SIM 1
97. sensor.testphone_ssidTestPhone SSID
98. sensor.testphone_storageTestPhone Storage
99. sensor.zigbee2mqtt_bridge_versionZigbee2MQTT Bridge Version

🚨เซนเซอร์สถานะ (มี/ไม่มี) 17

100. binary_sensor.bathroom_fall_alertแจ้งล้มห้องน้ำ / Bathroom Fall Alert
101. binary_sensor.bathroom_presenceคนอยู่ในห้องน้ำ / Bathroom Presence
102. binary_sensor.bathroom_water_leakน้ำรั่วห้องน้ำ / Bathroom Water Leak
103. binary_sensor.bathroom_water_leak_battery_lowbathroom_water_leak Battery
104. binary_sensor.bathroom_water_leak_water_leakbathroom_water_leak Moisture
105. binary_sensor.bedroom_fall_alertแจ้งล้มห้องนอน / Bedroom Fall Alert
106. binary_sensor.bedroom_presenceคนอยู่ในห้องนอน / Bedroom Presence
107. binary_sensor.front_doorประตูหน้า เปิด/ปิด / Front Door Contact
108. binary_sensor.front_door_sensor_battery_lowfront_door_sensor Battery
109. binary_sensor.front_door_sensor_contactfront_door_sensor Door
110. binary_sensor.garage_motionการเคลื่อนไหวโรงรถ / Garage Motion
111. binary_sensor.garage_smoke_alertแจ้งควัน/แก๊สโรงรถ / Garage Smoke Alert
112. binary_sensor.kitchen_gas_alertKitchen Gas Alert
113. binary_sensor.living_room_air_alertแจ้งอากาศเสีย / Air Quality Alert
114. binary_sensor.living_room_motionการเคลื่อนไหวห้องนั่งเล่น / Living Room Motion
115. binary_sensor.livingroom_pir_occupancylivingroom_pir Occupancy
116. binary_sensor.zigbee2mqtt_bridge_connection_stateZigbee2MQTT Bridge Connection state

🎛️ตัวเลือก 8

117. select.living_room_air_purifier_indicator_modeliving_room_air_purifier Indicator mode
118. select.living_room_air_purifier_power_outage_memoryliving_room_air_purifier Power outage memory
119. select.living_room_air_purifier_switch_type_buttonliving_room_air_purifier Switch type button
120. select.living_room_fan_indicator_modeliving_room_fan Indicator mode
121. select.living_room_fan_power_outage_memoryliving_room_fan Power outage memory
122. select.living_room_fan_switch_type_buttonliving_room_fan Switch type button
123. select.living_room_light_color_power_on_behaviorliving_room_light Color power on behavior
124. select.zigbee2mqtt_bridge_log_levelZigbee2MQTT Bridge Log level

🔢ค่าตัวเลขปรับได้ 3

125. number.living_room_air_purifier_countdownliving_room_air_purifier Countdown
126. number.living_room_fan_countdownliving_room_fan Countdown
127. number.livingroom_pir_motion_timeoutlivingroom_pir Motion timeout

🔘ปุ่มกด 3

128. button.living_room_air_purifier_identifyliving_room_air_purifier Identify
129. button.living_room_fan_identifyliving_room_fan Identify
130. button.zigbee2mqtt_bridge_restartZigbee2MQTT Bridge Restart

🟢สวิตช์เสมือน 6

131. input_boolean.alert_flash_activeAlert Flash Active
132. input_boolean.bathroom_light_manual_overrideBathroom Light Manual Override
133. input_boolean.bedroom_light_manual_overrideBedroom Light Manual Override
134. input_boolean.garage_light_manual_overrideGarage Light Manual Override
135. input_boolean.living_room_light_manual_overrideLiving Room Light Manual Override
136. input_boolean.party_loop_activeParty Loop Active

📍โหมด (เลือก) 2

137. input_select.comfort_modeComfort Mode
138. input_select.house_modeHouse Mode

⏺️ปุ่มเสมือน 5

139. input_button.scene_bedtimeScene Bedtime
140. input_button.scene_calmScene Calm
141. input_button.scene_defaultScene Default
142. input_button.scene_sunriseScene Sunrise
143. input_button.scene_welcomeScene Welcome

📜สคริปต์ 8

144. script.chavee_intrusion_response🚨 ชาวี Intrusion Response
145. script.living_room_blue_pulse💧 Living Room - Blue Pulse
146. script.living_room_party_off🛑 Party Mode OFF
147. script.living_room_party_on🎉 Party Mode ON
148. script.living_room_red_flash🚨 Living Room - Red Flash
149. script.living_room_sunrise🌅 Sunrise Wake-up
150. script.living_room_welcome_home🏠 Welcome Home
151. script.reset_normal🔄 Reset / กลับสู่ปกติ (หยุดทุกซีน/สัญญาณ)

⬆️อัปเดต 4

152. update.bathroom_water_leakbathroom_water_leak
153. update.living_room_air_purifierliving_room_air_purifier
154. update.living_room_fanliving_room_fan
155. update.livingroom_pirlivingroom_pir

📡ติดตามอุปกรณ์ 2

156. device_tracker.maradosxMaradosx
157. device_tracker.testphoneTestPhone

🧍บุคคล 1

158. person.athit_boonpinitAthit Boonpinit

🗺️โซน 1

159. zone.homeHome

☀️ดวงอาทิตย์ 1

160. sun.sunSun

⛅อากาศ 1

161. weather.forecast_baanForecast Home

🔊เสียงพูด 1

162. tts.google_translate_en_comGoogle Translate en com

💬สนทนา 1

163. conversation.home_assistantHome Assistant

📅อีเวนต์ 1

164. event.backup_automatic_backupBackup Automatic backup

✅รายการสิ่งที่ต้องทำ 1

165. todo.shopping_listShopping List

ภาคผนวก ข

## รายการ Automation ทั้งหมด (79)

ระบบอัตโนมัติทั้งหมด เลขเรียง 1–79 · ทำงาน 70 · ปิดไว้/ถูกแทนที่ 9 (ปิดตอน audit เพื่อกันทำงานซ้ำ/ชนกัน)

1. Auto Fan — Temperature > 30°Cทำงาน
2. Away Mode - LINE Notifyทำงาน
3. Away Mode - Turn Off All Devicesทำงาน
4. Bathroom Fall Alert - LINE Alertทำงาน
5. Bedroom Fall Alert - LINE Alertทำงาน
6. Front Door Intrusion Alertทำงาน
7. Garage Smoke Alert - LINE Alertทำงาน
8. Garden Light OFF — 23:00ปิดไว้
9. Garden Light ON — 18:00ทำงาน
10. Gas Alert - Auto Vent Fan ONทำงาน
11. Motion Light — Night Onlyไม่พร้อม
12. Security Mode - Turn Off All Devicesทำงาน
13. Sleep Mode - Turn Off All Lightsทำงาน
14. Soil Dry - LINE Alertทำงาน
15. Water Leak - LINE Alertทำงาน
16. 🌅 Auto-Off Bathroom Light (no presence 5min)ปิดไว้
17. 🌅 Auto-Off Bedroom Light (no motion 5min)ไม่พร้อม
18. 🌅 Auto-Off Garage Lights (no motion 5min)ปิดไว้
19. 🌅 Bedroom Curtain - Auto Close at Sunsetทำงาน
20. 🌅 Daily Sunrise Wake-up at 06:00ทำงาน
21. 🌅 รดน้ำอัตโนมัติ 07:00ทำงาน
22. 🌙 Sleep Path Light - Bedroom Motion → Living Dimทำงาน
23. 🌙 ปิดไฟทุกห้อง 23:00ทำงาน
24. 🌞 Bedroom Curtain - Auto Open after Sunrise +30minทำงาน
25. 🌱 Pump - Auto OFF (moisture target reached)ทำงาน
26. 🌱 Pump - Auto ON (dry + daytime + not raining)ทำงาน
27. 🌳 [Fix] garden_lights off on Away/Security/Sleep/23:00ทำงาน
28. 🎉 Party Button → Start Loopทำงาน
29. 🎨 Living Room Light - Mode Sceneปิดไว้
30. 🎨 Living Room Light - Mode Sceneปิดไว้
31. 🎨 Party Loop Executor (color cycle)ทำงาน
32. 🎬 Scene Bedtime - Smart Switchทำงาน
33. 🎬 Scene Calm - Smart Switchทำงาน
34. 🎬 Scene Default - Smart Switchทำงาน
35. 🎬 Scene Sunrise - Smart Switchทำงาน
36. 🎬 Scene Welcome - Smart Switchทำงาน
37. 🏠 GPS - กลับบ้าน → Home Modeปิดไว้
38. 🏠 GPS Welcome Home - Adaptive Outdoor Lights + Garageทำงาน
39. 💡 [Bathroom] Smart Light - Auto OFFทำงาน
40. 💡 [Bathroom] Smart Light - Auto ONทำงาน
41. 💡 [Bathroom] Smart Light - Detect Manual Overrideทำงาน
42. 💡 [Bedroom] Smart Light - Auto OFFทำงาน
43. 💡 [Bedroom] Smart Light - Auto ONทำงาน
44. 💡 [Bedroom] Smart Light - Detect Manual Overrideทำงาน
45. 💡 [Garage] Smart Light - Auto OFFทำงาน
46. 💡 [Garage] Smart Light - Auto ONทำงาน
47. 💡 [Garage] Smart Light - Detect Manual Overrideทำงาน
48. 💡 [Living Room] Smart Light - Auto OFFทำงาน
49. 💡 [Living Room] Smart Light - Auto ONทำงาน
50. 💡 [Living Room] Smart Light - Detect Manual Overrideทำงาน
51. 💡 Comfort Mode → Light Auto Colorทำงาน
52. 💨 [Fix] air purifier auto by AQI (air_alert)ทำงาน
53. 💨 Auto Fan OFF — Living Room < 28°C (hysteresis)ทำงาน
54. 💨 Sleep Mode - Bedroom Auto-Fan if Hotทำงาน
55. 💨 Sleep Mode - Bedroom Auto-Fan OFF when coolทำงาน
56. 💬 ChAvee Bypass - LINE Webhook Handlerทำงาน
57. 📍 GPS - ออกจากบ้าน → Away Modeปิดไว้
58. 📱 [Mobile+LINE] Bathroom Fall - ALL CHANNELSทำงาน
59. 📱 [Mobile+LINE] Comfort Mode Changeทำงาน
60. 📱 [Mobile+LINE] Door Intrusion (Away/Security)ทำงาน
61. 📱 [Mobile+LINE] Garage Door Stateทำงาน
62. 📱 [Mobile+LINE] Garden Pump State Changeทำงาน
63. 📱 [Mobile+LINE] Gas Alert - ALL CHANNELSทำงาน
64. 📱 [Mobile+LINE] House Mode Changeทำงาน
65. 📱 [Mobile+LINE] Water Leak - ALL CHANNELSทำงาน
66. 🔒 [Fix] Away - close garage + lock front doorทำงาน
67. 🔒 [Fix] Security - lock front doorทำงาน
68. 🔥 Stove Safety - Auto-OFF if abandoned 15minทำงาน
69. 🔥 Stove Safety - Warning if abandoned 10minทำงาน
70. 🚗 [Fix] garage auto-close 5 min after openingทำงาน
71. 🚨 [Fix] sustained alert flash > 10 min -> auto clearทำงาน
72. 🚨 Alert Flash - Red Blink Loopทำงาน
73. 🚨 Pump - Safety Max Runtime (10 min)ทำงาน
74. 🚪 GPS Goodbye - Auto Away after 2min graceทำงาน
75. 🚪 แจ้งเตือนประตูหน้าเปิดนานเกิน 10 นาทีทำงาน
76. 🚪 แจ้งเตือนประตูไม่ล็อกนานเกิน 10 นาทีทำงาน
77. 🛋 Relax Mode - Auto Fan if Hotทำงาน
78. 🛑 Party Loop - Safety Auto-Off (30 min)ทำงาน
79. 🛑 Party Off Button → Stop Loopทำงาน

Smart Home AIoT — คู่มือบ้านอัจฉริยะ · Athit "Mos" Boonpinit · Bangkok University CE08
244 entities79 automationsClaude Haiku 4.5Home Assistant + MQTTZigbee + ESP32อัปเดต 23 มิ.ย. 2569
