Maradosx/smart-home-aiot/test_sheets/00_ALL_130_tests.pdf

Smart Home AIoT — Senior Project CE08 | Page 1

## Smart Home AIoT — Test Data Collection Sheet — All 130 Tests

Senior Project CE08 — Bangkok University
Generated: 2026-05-25 22:46

Instructions for use:
1. Run each test 10 times consecutively (or across sessions, as practical)
2. Record: Date, Time, exact Input given, Actual Output observed, Response Time (use stopwatch), and Pass/Fail
3. Pass criteria: Actual matches Expected description
4. After 10 trials, calculate: Pass Rate %, Average Response Time, Standard Deviation
5. Use Comments for any anomalies or special observations

Statistical formulas:
- Pass Rate = (Pass Count / 10) × 100%
- Avg RT = (response times) / 10
- Variance = (xi - )² / n
- Std Dev = √variance

Coverage Matrix
Phase | Description | Count
Phase A | Phase A — Single Device Verification | 16
Phase B | Phase B — Sensor Reading | 18
Phase C | Phase C — Mode Change & Cascading | 10
Phase D | Phase D — Safety Auto-Flows Simulation | 12
Phase E | Phase E — Adaptive Lighting | 8
Phase F | Phase F — GPS Welcome/Goodbye | 8
Phase G | Phase G — Schedule Automations | 7
Phase H | Phase H — AI Agent (LINE Thai + Alexa EN + Deep Reasoning) | 39
Phase I | Phase I — Integration Tests | 12
| TOTAL | 130

## Phase A — Single Device Verification

A01 | Bedroom Light | Phase A
Method: | HA | toggle switch.bedroom_light
Expected: ไฟห้องนอนติด/ดับ + state เปลี่ยน
# | Date | Time | Input/Command | Actual Output | RT (ms) | P/F | Notes

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
Pass Count: ___/10 | Pass Rate: ____% | Avg RT: ____ ms | Std Dev: ____ ms
Comments:

A02 | Living Room Light (Tuya RGB) | Phase A
Method: | HA | toggle light.living_room_light
Expected: Tuya bulb ON ที่ color default
# | Date | Time | Input/Command | Actual Output | RT (ms) | P/F | Notes

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
Pass Count: ___/10 | Pass Rate: ____% | Avg RT: ____ ms | Std Dev: ____ ms
Comments:

A03 | Kitchen Light | Phase A
Method: | HA | toggle switch.kitchen_light
Expected: ไฟครัวติด/ดับ
# | Date | Time | Input/Command | Actual Output | RT (ms) | P/F | Notes

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
Pass Count: ___/10 | Pass Rate: ____% | Avg RT: ____ ms | Std Dev: ____ ms
Comments:

A04 | Bathroom Light | Phase A
Method: | HA | toggle switch.bathroom_light
Expected: ไฟห้องน้ำติด/ดับ
# | Date | Time | Input/Command | Actual Output | RT (ms) | P/F | Notes

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
Pass Count: ___/10 | Pass Rate: ____% | Avg RT: ____ ms | Std Dev: ____ ms
Comments:

A05 | Garden Light | Phase A
Method: | HA | toggle switch.garden_light
Expected: ไฟสวนหลักติด/ดับ
# | Date | Time | Input/Command | Actual Output | RT (ms) | P/F | Notes

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
Pass Count: ___/10 | Pass Rate: ____% | Avg RT: ____ ms | Std Dev: ____ ms
Comments:

A06 | Garage Light | Phase A
Method: | HA | toggle switch.garage_light
Expected: ไฟโรงรถหลักติด/ดับ
# | Date | Time | Input/Command | Actual Output | RT (ms) | P/F | Notes

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
Pass Count: ___/10 | Pass Rate: ____% | Avg RT: ____ ms | Std Dev: ____ ms
Comments:

A07 | Garage Pathway Light | Phase A
Method: | HA | toggle switch.garage_pathway_light
Expected: ไฟทางเดินโรงรถ
# | Date | Time | Input/Command | Actual Output | RT (ms) | P/F | Notes

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
Pass Count: ___/10 | Pass Rate: ____% | Avg RT: ____ ms | Std Dev: ____ ms
Comments:

A08 | Garden Pathway Light | Phase A
Method: | HA | toggle switch.garden_pathway_light
Expected: ไฟทางเดินสวน
# | Date | Time | Input/Command | Actual Output | RT (ms) | P/F | Notes

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
Pass Count: ___/10 | Pass Rate: ____% | Avg RT: ____ ms | Std Dev: ____ ms
Comments:

A09 | Bedroom Fan | Phase A
Method: | HA | toggle switch.bedroom_fan
Expected: พัดลมห้องนอนหมุน
# | Date | Time | Input/Command | Actual Output | RT (ms) | P/F | Notes

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
Pass Count: ___/10 | Pass Rate: ____% | Avg RT: ____ ms | Std Dev: ____ ms
Comments:

A10 | Living Room Fan (Tuya plug) | Phase A
Method: | HA | toggle switch.living_room_fan
Expected: พัดลมห้องนั่งเล่นหมุน
# | Date | Time | Input/Command | Actual Output | RT (ms) | P/F | Notes

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
Pass Count: ___/10 | Pass Rate: ____% | Avg RT: ____ ms | Std Dev: ____ ms
Comments:

A11 | Kitchen Vent Fan | Phase A
Method: | HA | toggle switch.kitchen_fan
Expected: vent fan ครัวทำงาน
# | Date | Time | Input/Command | Actual Output | RT (ms) | P/F | Notes

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
Pass Count: ___/10 | Pass Rate: ____% | Avg RT: ____ ms | Std Dev: ____ ms
Comments:

A12 | Bedroom Curtain — Open | Phase A
Method: | HA | cover.bedroom_curtain open
Expected: ม่านพับเก็บขึ้น (หน้าต่างโล่ง)
# | Date | Time | Input/Command | Actual Output | RT (ms) | P/F | Notes

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
Pass Count: ___/10 | Pass Rate: ____% | Avg RT: ____ ms | Std Dev: ____ ms
Comments:

A13 | Bedroom Curtain — Close | Phase A
Method: | HA | cover.bedroom_curtain close
Expected: ม่านลงคลุมหน้าต่าง
# | Date | Time | Input/Command | Actual Output | RT (ms) | P/F | Notes

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
Pass Count: ___/10 | Pass Rate: ____% | Avg RT: ____ ms | Std Dev: ____ ms
Comments:

A14 | Front Door Lock | Phase A
Method: | HA | lock.front_door_lock
Expected: servo หมุน 090°
# | Date | Time | Input/Command | Actual Output | RT (ms) | P/F | Notes

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
Pass Count: ___/10 | Pass Rate: ____% | Avg RT: ____ ms | Std Dev: ____ ms
Comments:

A15 | Garage Door | Phase A
Method: | HA | cover.garage_door open/close
Expected: servo หมุนเปิด/ปิด
# | Date | Time | Input/Command | Actual Output | RT (ms) | P/F | Notes

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
Pass Count: ___/10 | Pass Rate: ____% | Avg RT: ____ ms | Std Dev: ____ ms
Comments:

A16 | Garden Water Pump | Phase A
Method: | HA | toggle switch.garden_water_pump
Expected: ปั๊มทำงาน + น้ำไหล
# | Date | Time | Input/Command | Actual Output | RT (ms) | P/F | Notes

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
Pass Count: ___/10 | Pass Rate: ____% | Avg RT: ____ ms | Std Dev: ____ ms
Comments:

## Phase B — Sensor Reading

B01 | Bedroom Temperature + Humidity (DHT22) | Phase B
Method: | ดู HA Dashboard sensor.bedroom_temperature, humidity
Expected: 20-35°C, 40-80% (sanity range)
# | Date | Time | Input/Command | Actual Output | RT (ms) | P/F | Notes

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
Pass Count: ___/10 | Pass Rate: ____% | Avg RT: ____ ms | Std Dev: ____ ms
Comments:

B02 | Living Room Temperature + Humidity | Phase B
Method: | ดู HA sensor.living_room_temperature, humidity
Expected: same range
# | Date | Time | Input/Command | Actual Output | RT (ms) | P/F | Notes

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
Pass Count: ___/10 | Pass Rate: ____% | Avg RT: ____ ms | Std Dev: ____ ms
Comments:

B03 | Kitchen Temperature + Humidity | Phase B
Method: | ดู HA sensor.kitchen_temperature, humidity
Expected: same range
# | Date | Time | Input/Command | Actual Output | RT (ms) | P/F | Notes

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
Pass Count: ___/10 | Pass Rate: ____% | Avg RT: ____ ms | Std Dev: ____ ms
Comments:

B04 | Bedroom LDR | Phase B
Method: | ดู sensor.bedroom_ldr + เอามือบังเซ็นเซอร์ | ค่าเพิ่ม
Expected: 0-4095 range (high=มืด)
# | Date | Time | Input/Command | Actual Output | RT (ms) | P/F | Notes

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
Pass Count: ___/10 | Pass Rate: ____% | Avg RT: ____ ms | Std Dev: ____ ms
Comments:

B05 | Living Room LDR | Phase B
Method: | sanity test
Expected: 0-4095
# | Date | Time | Input/Command | Actual Output | RT (ms) | P/F | Notes

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
Pass Count: ___/10 | Pass Rate: ____% | Avg RT: ____ ms | Std Dev: ____ ms
Comments:

B06 | Kitchen LDR | Phase B
Method: | sanity test
Expected: 0-4095
# | Date | Time | Input/Command | Actual Output | RT (ms) | P/F | Notes

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
Pass Count: ___/10 | Pass Rate: ____% | Avg RT: ____ ms | Std Dev: ____ ms
Comments:

B07 | Bathroom LDR | Phase B
Method: | sanity test
Expected: 0-4095
# | Date | Time | Input/Command | Actual Output | RT (ms) | P/F | Notes

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
Pass Count: ___/10 | Pass Rate: ____% | Avg RT: ____ ms | Std Dev: ____ ms
Comments:

B08 | Garden LDR | Phase B
Method: | sanity test
Expected: 0-4095
# | Date | Time | Input/Command | Actual Output | RT (ms) | P/F | Notes

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
Pass Count: ___/10 | Pass Rate: ____% | Avg RT: ____ ms | Std Dev: ____ ms
Comments:

B09 | Garage LDR | Phase B
Method: | sanity test
Expected: 0-4095
# | Date | Time | Input/Command | Actual Output | RT (ms) | P/F | Notes

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
Pass Count: ___/10 | Pass Rate: ____% | Avg RT: ____ ms | Std Dev: ____ ms
Comments:

B10 | Kitchen Gas (MQ-2) | Phase B
Method: | จุดไฟแช็คใกล้ | sensor.kitchen_gas_lpg ค่าขึ้น
Expected: ADC ขึ้นจาก baseline
# | Date | Time | Input/Command | Actual Output | RT (ms) | P/F | Notes

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
Pass Count: ___/10 | Pass Rate: ____% | Avg RT: ____ ms | Std Dev: ____ ms
Comments:

B11 | Garage Smoke (MQ-2) | Phase B
Method: | จุดไฟแช็ค/สเปรย์ | sensor.garage_smoke_lpg ค่าขึ้น
Expected: ADC ขึ้นจาก baseline
# | Date | Time | Input/Command | Actual Output | RT (ms) | P/F | Notes

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
Pass Count: ___/10 | Pass Rate: ____% | Avg RT: ____ ms | Std Dev: ____ ms
Comments:

B12 | Garden Soil Moisture | Phase B
Method: | แตะดินเปียก vs แห้ง | % เปลี่ยน
Expected: 0-100% range
# | Date | Time | Input/Command | Actual Output | RT (ms) | P/F | Notes

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
Pass Count: ___/10 | Pass Rate: ____% | Avg RT: ____ ms | Std Dev: ____ ms
Comments:

B13 | Bathroom Water Leak (SNZB-05P) | Phase B
Method: | แตะน้ำที่ขาทองแดง | binary_sensor.bathroom_water_leak ON
Expected: binary state ON
# | Date | Time | Input/Command | Actual Output | RT (ms) | P/F | Notes

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
Pass Count: ___/10 | Pass Rate: ____% | Avg RT: ____ ms | Std Dev: ____ ms
Comments:

B14 | Front Door Contact (SNZB-04) | Phase B
Method: | เปิด/ปิดประตู | binary_sensor.front_door ON/OFF
Expected: binary state เปลี่ยน
# | Date | Time | Input/Command | Actual Output | RT (ms) | P/F | Notes

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
Pass Count: ___/10 | Pass Rate: ____% | Avg RT: ____ ms | Std Dev: ____ ms
Comments:

B15 | Bedroom Motion (PIR) | Phase B
Method: | เดินผ่าน | binary_sensor.bedroom_motion ON
Expected: ON 30s window
# | Date | Time | Input/Command | Actual Output | RT (ms) | P/F | Notes

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
Pass Count: ___/10 | Pass Rate: ____% | Avg RT: ____ ms | Std Dev: ____ ms
Comments:

B16 | Living Room Motion (Zigbee PIR) | Phase B
Method: | เดินผ่าน | binary_sensor.living_room_motion ON
Expected: ON
# | Date | Time | Input/Command | Actual Output | RT (ms) | P/F | Notes

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
Pass Count: ___/10 | Pass Rate: ____% | Avg RT: ____ ms | Std Dev: ____ ms
Comments:

B17 | Bathroom Presence (LD2410) | Phase B
Method: | เดินเข้า | binary_sensor.bathroom_presence ON
Expected: ON
# | Date | Time | Input/Command | Actual Output | RT (ms) | P/F | Notes

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
Pass Count: ___/10 | Pass Rate: ____% | Avg RT: ____ ms | Std Dev: ____ ms
Comments:

B18 | Garage Motion (PIR) | Phase B
Method: | เดินผ่าน | binary_sensor.garage_motion ON
Expected: ON 30s timeout
# | Date | Time | Input/Command | Actual Output | RT (ms) | P/F | Notes

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
Pass Count: ___/10 | Pass Rate: ____% | Avg RT: ____ ms | Std Dev: ____ ms
Comments:

## Phase C — Mode Change & Cascading

C01 | House Mode | Home | Phase C
Method: | Set input_select.house_mode = Home
Expected: Mode Scene fires + adaptive ON + GPS welcome enabled
# | Date | Time | Input/Command | Actual Output | RT (ms) | P/F | Notes

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
Pass Count: ___/10 | Pass Rate: ____% | Avg RT: ____ ms | Std Dev: ____ ms
Comments:

C02 | House Mode | Away | Phase C
Method: | Set input_select.house_mode = Away
Expected: ทุก switch OFF + lock + curtain close + LINE notify
# | Date | Time | Input/Command | Actual Output | RT (ms) | P/F | Notes

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
Pass Count: ___/10 | Pass Rate: ____% | Avg RT: ____ ms | Std Dev: ____ ms
Comments:

C03 | House Mode | Security | Phase C
Method: | Set input_select.house_mode = Security
Expected: ปิดทุก + monitor active (door open = intrusion)
# | Date | Time | Input/Command | Actual Output | RT (ms) | P/F | Notes

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
Pass Count: ___/10 | Pass Rate: ____% | Avg RT: ____ ms | Std Dev: ____ ms
Comments:

C04 | Comfort Mode | Normal | Phase C
Method: | Set input_select.comfort_mode = Normal
Expected: adaptive light ON, sensors active
# | Date | Time | Input/Command | Actual Output | RT (ms) | P/F | Notes

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
Pass Count: ___/10 | Pass Rate: ____% | Avg RT: ____ ms | Std Dev: ____ ms
Comments:

C05 | Comfort Mode | Sleep | Phase C
Method: | Set comfort_mode = Sleep
Expected: ปิดไฟทุกห้อง + curtain close + path-light enabled
# | Date | Time | Input/Command | Actual Output | RT (ms) | P/F | Notes

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
Pass Count: ___/10 | Pass Rate: ____% | Avg RT: ____ ms | Std Dev: ____ ms
Comments:

C06 | Comfort Mode | Relax | Phase C
Method: | Set comfort_mode = Relax
Expected: Tuya warm 60% + auto-fan if >28°C
# | Date | Time | Input/Command | Actual Output | RT (ms) | P/F | Notes

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
Pass Count: ___/10 | Pass Rate: ____% | Avg RT: ____ ms | Std Dev: ____ ms
Comments:

C07 | Comfort Mode | Warm | Phase C
Method: | Set comfort_mode = Warm
Expected: Tuya 2700K + ปิดพัดลม
# | Date | Time | Input/Command | Actual Output | RT (ms) | P/F | Notes

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
Pass Count: ___/10 | Pass Rate: ____% | Avg RT: ____ ms | Std Dev: ____ ms
Comments:

C08 | Cascade: Home | Away | Home | Phase C
Method: | เปลี่ยน mode รัวๆ 3 ครั้ง
Expected: All devices end at correct state
# | Date | Time | Input/Command | Actual Output | RT (ms) | P/F | Notes

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
Pass Count: ___/10 | Pass Rate: ____% | Avg RT: ____ ms | Std Dev: ____ ms
Comments:

C09 | Concurrent: Home + Sleep | Phase C
Method: | Set both
Expected: Path-light ON, adaptive OFF
# | Date | Time | Input/Command | Actual Output | RT (ms) | P/F | Notes

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
Pass Count: ___/10 | Pass Rate: ____% | Avg RT: ____ ms | Std Dev: ____ ms
Comments:

C10 | Cascade: Sleep | Normal | Phase C
Method: | Change Sleep | Normal
Expected: Auto-fan stops, adaptive resumes
# | Date | Time | Input/Command | Actual Output | RT (ms) | P/F | Notes

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
Pass Count: ___/10 | Pass Rate: ____% | Avg RT: ____ ms | Std Dev: ____ ms
Comments:

## Phase D — Safety Auto-Flows Simulation

D01 | Gas Alert — Stove OFF | Phase D
Method: | mosquitto_pub home/kitchen/gas_alert ON
Expected: switch.kitchen_stove | OFF (double-block)
# | Date | Time | Input/Command | Actual Output | RT (ms) | P/F | Notes

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
Pass Count: ___/10 | Pass Rate: ____% | Avg RT: ____ ms | Std Dev: ____ ms
Comments:

D02 | Gas Alert — Vent Fan ON | Phase D
Method: | gas_alert trigger
Expected: switch.kitchen_fan | ON
# | Date | Time | Input/Command | Actual Output | RT (ms) | P/F | Notes

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
Pass Count: ___/10 | Pass Rate: ____% | Avg RT: ____ ms | Std Dev: ____ ms
Comments:

D03 | Gas Alert — Red Flash | Phase D
Method: | gas_alert trigger
Expected: script.living_room_red_flash fired (Tuya แดงพริบ)
# | Date | Time | Input/Command | Actual Output | RT (ms) | P/F | Notes

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
Pass Count: ___/10 | Pass Rate: ____% | Avg RT: ____ ms | Std Dev: ____ ms
Comments:

D04 | Gas Alert — LINE Message | Phase D
Method: | gas_alert trigger
Expected: LINE message " | ก๊าซรั่ว!" arrives
# | Date | Time | Input/Command | Actual Output | RT (ms) | P/F | Notes

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
Pass Count: ___/10 | Pass Rate: ____% | Avg RT: ____ ms | Std Dev: ____ ms
Comments:

D05 | Water Leak Detection | Phase D
Method: | แตะน้ำที่ probe / force binary_sensor.bathroom_water_leak = on
Expected: blue pulse + LINE " | น้ำรั่ว!"
# | Date | Time | Input/Command | Actual Output | RT (ms) | P/F | Notes

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
Pass Count: ___/10 | Pass Rate: ____% | Avg RT: ____ ms | Std Dev: ____ ms
Comments:

D06 | Bathroom Fall — Scene Snapshot | Phase D
Method: | force binary_sensor.bathroom_fall_alert = on
Expected: scene.livingroom_pre_fall_alert saved
# | Date | Time | Input/Command | Actual Output | RT (ms) | P/F | Notes

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
Pass Count: ___/10 | Pass Rate: ____% | Avg RT: ____ ms | Std Dev: ____ ms
Comments:

D07 | Bathroom Fall — Red Flash 30s | Phase D
Method: | fall_alert trigger
Expected: ไฟแดงพริบ 30 วินาที (10 รอบ)
# | Date | Time | Input/Command | Actual Output | RT (ms) | P/F | Notes

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
Pass Count: ___/10 | Pass Rate: ____% | Avg RT: ____ ms | Std Dev: ____ ms
Comments:

D08 | Bathroom Fall — LINE + Restore | Phase D
Method: | fall_alert trigger
Expected: LINE " | คนล้ม!" + scene restore กลับ
# | Date | Time | Input/Command | Actual Output | RT (ms) | P/F | Notes

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
Pass Count: ___/10 | Pass Rate: ____% | Avg RT: ____ ms | Std Dev: ____ ms
Comments:

D09 | Garage Smoke Alert | Phase D
Method: | mosquitto_pub home/garage/smoke_alert ON
Expected: Red flash + LINE " | ควันโรงรถ!"
# | Date | Time | Input/Command | Actual Output | RT (ms) | P/F | Notes

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
Pass Count: ___/10 | Pass Rate: ____% | Avg RT: ____ ms | Std Dev: ____ ms
Comments:

D10 | Front Door Intrusion (Security) | Phase D
Method: | Set Security + force door open
Expected: Auto-lock + Red flash + LINE " | มีคนบุก!"
# | Date | Time | Input/Command | Actual Output | RT (ms) | P/F | Notes

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
Pass Count: ___/10 | Pass Rate: ____% | Avg RT: ____ ms | Std Dev: ____ ms
Comments:

D11 | Soil Dry — Auto Pump | Phase D
Method: | mosquitto_pub home/garden/soil_moisture 25
Expected: switch.garden_water_pump ON + LINE " | ดินแห้ง"
# | Date | Time | Input/Command | Actual Output | RT (ms) | P/F | Notes

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
Pass Count: ___/10 | Pass Rate: ____% | Avg RT: ____ ms | Std Dev: ____ ms
Comments:

D12 | Stove Safety (10-min warning, 15-min Away auto-off) | Phase D
Method: | stove ON 10/15 min + Away
Expected: LINE warning + auto-OFF
# | Date | Time | Input/Command | Actual Output | RT (ms) | P/F | Notes

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
Pass Count: ___/10 | Pass Rate: ____% | Avg RT: ____ ms | Std Dev: ____ ms
Comments:

## Phase E — Adaptive Lighting

E01 | Bedroom Adaptive (PIR + LDR) | Phase E
Method: | Setup LDR > 2200 + walk PIR
Expected: switch.bedroom_light ON
# | Date | Time | Input/Command | Actual Output | RT (ms) | P/F | Notes

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
Pass Count: ___/10 | Pass Rate: ____% | Avg RT: ____ ms | Std Dev: ____ ms
Comments:

E02 | Living Room Adaptive (Zigbee PIR + LDR + brightness scale) | Phase E
Method: | LDR > 2200 + motion
Expected: Tuya bulb ON brightness scaled by LDR (30-100%)
# | Date | Time | Input/Command | Actual Output | RT (ms) | P/F | Notes

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
Pass Count: ___/10 | Pass Rate: ____% | Avg RT: ____ ms | Std Dev: ____ ms
Comments:

E03 | Bathroom Adaptive (LD2410 + LDR) | Phase E
Method: | LDR > 2000 + presence
Expected: switch.bathroom_light ON
# | Date | Time | Input/Command | Actual Output | RT (ms) | P/F | Notes

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
Pass Count: ___/10 | Pass Rate: ____% | Avg RT: ____ ms | Std Dev: ____ ms
Comments:

E04 | Garage Adaptive (PIR + LDR) | Phase E
Method: | LDR > 2400 + motion
Expected: garage_light + pathway_light ON
# | Date | Time | Input/Command | Actual Output | RT (ms) | P/F | Notes

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
Pass Count: ___/10 | Pass Rate: ____% | Avg RT: ____ ms | Std Dev: ____ ms
Comments:

E05 | Adaptive NO-trigger (สว่างพอ) | Phase E
Method: | LDR < 2200 + motion
Expected: light ยัง OFF (no trigger)
# | Date | Time | Input/Command | Actual Output | RT (ms) | P/F | Notes

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
Pass Count: ___/10 | Pass Rate: ____% | Avg RT: ____ ms | Std Dev: ____ ms
Comments:

E06 | Bedroom Auto-off (5 min) | Phase E
Method: | turn on light + no motion 5 min
Expected: auto OFF
# | Date | Time | Input/Command | Actual Output | RT (ms) | P/F | Notes

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
Pass Count: ___/10 | Pass Rate: ____% | Avg RT: ____ ms | Std Dev: ____ ms
Comments:

E07 | Garage Auto-off (5 min) | Phase E
Method: | turn on lights + no motion 5 min
Expected: both garage lights OFF
# | Date | Time | Input/Command | Actual Output | RT (ms) | P/F | Notes

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
Pass Count: ___/10 | Pass Rate: ____% | Avg RT: ____ ms | Std Dev: ____ ms
Comments:

E08 | Bathroom Auto-off (5 min) | Phase E
Method: | light on + no presence 5 min
Expected: bath light OFF
# | Date | Time | Input/Command | Actual Output | RT (ms) | P/F | Notes

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
Pass Count: ___/10 | Pass Rate: ____% | Avg RT: ____ ms | Std Dev: ____ ms
Comments:

## Phase F — GPS Welcome/Goodbye

F01 | GPS Welcome — Garage Door Open | Phase F
Method: | Mock person | home
Expected: cover.garage_door opening
# | Date | Time | Input/Command | Actual Output | RT (ms) | P/F | Notes

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
Pass Count: ___/10 | Pass Rate: ____% | Avg RT: ____ ms | Std Dev: ____ ms
Comments:

F02 | GPS Welcome — Garage Lights (LDR-aware) | Phase F
Method: | garden_ldr > 2400 + welcome
Expected: garage_light + pathway ON
# | Date | Time | Input/Command | Actual Output | RT (ms) | P/F | Notes

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
Pass Count: ___/10 | Pass Rate: ____% | Avg RT: ____ ms | Std Dev: ____ ms
Comments:

F03 | GPS Welcome — Garden Lights | Phase F
Method: | garden_ldr > 2200 + welcome
Expected: garden_light + pathway ON
# | Date | Time | Input/Command | Actual Output | RT (ms) | P/F | Notes

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
Pass Count: ___/10 | Pass Rate: ____% | Avg RT: ____ ms | Std Dev: ____ ms
Comments:

F04 | GPS Welcome — Switch Away | Home | Phase F
Method: | Set Away + GPS welcome
Expected: house_mode | Home auto
# | Date | Time | Input/Command | Actual Output | RT (ms) | P/F | Notes

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
Pass Count: ___/10 | Pass Rate: ____% | Avg RT: ____ ms | Std Dev: ____ ms
Comments:

F05 | GPS Welcome — LINE Notify | Phase F
Method: | GPS welcome
Expected: LINE "ยินดีต้อนรับ"
# | Date | Time | Input/Command | Actual Output | RT (ms) | P/F | Notes

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
Pass Count: ___/10 | Pass Rate: ____% | Avg RT: ____ ms | Std Dev: ____ ms
Comments:

F06 | GPS Goodbye — 2-min grace | Phase F
Method: | person | not_home + wait 2 min
Expected: house_mode | Away
# | Date | Time | Input/Command | Actual Output | RT (ms) | P/F | Notes

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
Pass Count: ___/10 | Pass Rate: ____% | Avg RT: ____ ms | Std Dev: ____ ms
Comments:

F07 | GPS Goodbye — Cascade | Phase F
Method: | Goodbye trigger
Expected: switches OFF + lock + curtain close
# | Date | Time | Input/Command | Actual Output | RT (ms) | P/F | Notes

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
Pass Count: ___/10 | Pass Rate: ____% | Avg RT: ____ ms | Std Dev: ____ ms
Comments:

F08 | GPS Goodbye — LINE Notify | Phase F
Method: | Goodbye trigger
Expected: LINE goodbye message (random variant)
# | Date | Time | Input/Command | Actual Output | RT (ms) | P/F | Notes

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
Pass Count: ___/10 | Pass Rate: ____% | Avg RT: ____ ms | Std Dev: ____ ms
Comments:

## Phase G — Schedule Automations

G01 | Daily Watering 07:00 (10s) | Phase G
Method: | wait or force time = 07:00
Expected: pump turn_on | 10s | turn_off
# | Date | Time | Input/Command | Actual Output | RT (ms) | P/F | Notes

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
Pass Count: ___/10 | Pass Rate: ____% | Avg RT: ____ ms | Std Dev: ____ ms
Comments:

G02 | Lights OFF 23:00 | Phase G
Method: | wait or force time = 23:00
Expected: all lights OFF
# | Date | Time | Input/Command | Actual Output | RT (ms) | P/F | Notes

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
Pass Count: ___/10 | Pass Rate: ____% | Avg RT: ____ ms | Std Dev: ____ ms
Comments:

G03 | Daily Sunrise 06:00 | Phase G
Method: | wait or force time = 06:00
Expected: Tuya gradual brighten
# | Date | Time | Input/Command | Actual Output | RT (ms) | P/F | Notes

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
Pass Count: ___/10 | Pass Rate: ____% | Avg RT: ____ ms | Std Dev: ____ ms
Comments:

G04 | Garden Light ON 18:00 | Phase G
Method: | wait or force time = 18:00
Expected: switch.garden_light ON
# | Date | Time | Input/Command | Actual Output | RT (ms) | P/F | Notes

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
Pass Count: ___/10 | Pass Rate: ____% | Avg RT: ____ ms | Std Dev: ____ ms
Comments:

G05 | Garden Light OFF 23:00 | Phase G
Method: | wait or force time = 23:00
Expected: switch.garden_light OFF
# | Date | Time | Input/Command | Actual Output | RT (ms) | P/F | Notes

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
Pass Count: ___/10 | Pass Rate: ____% | Avg RT: ____ ms | Std Dev: ____ ms
Comments:

G06 | Sunset Curtain Close | Phase G
Method: | force sun.sun | below_horizon (Home mode)
Expected: bedroom_curtain close
# | Date | Time | Input/Command | Actual Output | RT (ms) | P/F | Notes

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
Pass Count: ___/10 | Pass Rate: ____% | Avg RT: ____ ms | Std Dev: ____ ms
Comments:

G07 | Sunrise+30min Curtain Open | Phase G
Method: | force sun event + 30 min (not Sleep)
Expected: bedroom_curtain open
# | Date | Time | Input/Command | Actual Output | RT (ms) | P/F | Notes

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
Pass Count: ___/10 | Pass Rate: ____% | Avg RT: ____ ms | Std Dev: ____ ms
Comments:

## Phase H — AI Agent (LINE Thai + Alexa EN + Deep Reasoning)

H01 | LINE: "เปิดไฟห้องนอน" | Phase H
Method: | ส่ง LINE
Expected: switch.bedroom_light ON + Thai reply
# | Date | Time | Input/Command | Actual Output | RT (ms) | P/F | Notes

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
Pass Count: ___/10 | Pass Rate: ____% | Avg RT: ____ ms | Std Dev: ____ ms
Comments:

H02 | LINE: "ปิดทุกอย่าง" | Phase H
Method: | ส่ง LINE
Expected: all switches OFF
# | Date | Time | Input/Command | Actual Output | RT (ms) | P/F | Notes

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
Pass Count: ___/10 | Pass Rate: ____% | Avg RT: ____ ms | Std Dev: ____ ms
Comments:

H03 | LINE: "นอนแล้ว" | Phase H
Method: | ส่ง LINE
Expected: Sleep mode + cascade
# | Date | Time | Input/Command | Actual Output | RT (ms) | P/F | Notes

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
Pass Count: ___/10 | Pass Rate: ____% | Avg RT: ____ ms | Std Dev: ____ ms
Comments:

H04 | LINE: "ออกจากบ้าน" | Phase H
Method: | ส่ง LINE
Expected: Away mode + cascade
# | Date | Time | Input/Command | Actual Output | RT (ms) | P/F | Notes

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
Pass Count: ___/10 | Pass Rate: ____% | Avg RT: ____ ms | Std Dev: ____ ms
Comments:

H05 | LINE: "อุณหภูมิครัว" | Phase H
Method: | ส่ง LINE
Expected: sensor reply with °C value
# | Date | Time | Input/Command | Actual Output | RT (ms) | P/F | Notes

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
Pass Count: ___/10 | Pass Rate: ____% | Avg RT: ____ ms | Std Dev: ____ ms
Comments:

H06 | LINE: "เปลี่ยนสีไฟเป็นแดง" | Phase H
Method: | ส่ง LINE
Expected: Tuya bulb red
# | Date | Time | Input/Command | Actual Output | RT (ms) | P/F | Notes

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
Pass Count: ___/10 | Pass Rate: ____% | Avg RT: ____ ms | Std Dev: ____ ms
Comments:

H07 | LINE: "ปาร์ตี้!" | Phase H
Method: | ส่ง LINE
Expected: Party scene (colorloop) fires
# | Date | Time | Input/Command | Actual Output | RT (ms) | P/F | Notes

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
Pass Count: ___/10 | Pass Rate: ____% | Avg RT: ____ ms | Std Dev: ____ ms
Comments:

H08 | LINE: "มีคนบุก" | Phase H
Method: | ส่ง LINE
Expected: Security mode + intrusion response
# | Date | Time | Input/Command | Actual Output | RT (ms) | P/F | Notes

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
Pass Count: ___/10 | Pass Rate: ____% | Avg RT: ____ ms | Std Dev: ____ ms
Comments:

H09 | LINE: "แก๊สรั่ว" | Phase H
Method: | ส่ง LINE
Expected: Gas alert simulated response
# | Date | Time | Input/Command | Actual Output | RT (ms) | P/F | Notes

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
Pass Count: ___/10 | Pass Rate: ____% | Avg RT: ____ ms | Std Dev: ____ ms
Comments:

H10 | LINE Multi-action: "เปิดไฟห้องนอน + ปิดไฟห้องครัว" | Phase H
Method: | ส่ง LINE
Expected: both actions fire
# | Date | Time | Input/Command | Actual Output | RT (ms) | P/F | Notes

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
Pass Count: ___/10 | Pass Rate: ____% | Avg RT: ____ ms | Std Dev: ____ ms
Comments:

H11 | Alexa: "turn on bedroom light" | Phase H
Method: | พูด Alexa
Expected: switch.bedroom_light ON + TTS confirm
# | Date | Time | Input/Command | Actual Output | RT (ms) | P/F | Notes

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
Pass Count: ___/10 | Pass Rate: ____% | Avg RT: ____ ms | Std Dev: ____ ms
Comments:

H12 | Alexa: "kitchen fan on" | Phase H
Method: | พูด Alexa
Expected: fan ON
# | Date | Time | Input/Command | Actual Output | RT (ms) | P/F | Notes

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
Pass Count: ___/10 | Pass Rate: ____% | Avg RT: ____ ms | Std Dev: ____ ms
Comments:

H13 | Alexa: "open garage door" | Phase H
Method: | พูด Alexa
Expected: cover.garage_door open
# | Date | Time | Input/Command | Actual Output | RT (ms) | P/F | Notes

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
Pass Count: ___/10 | Pass Rate: ____% | Avg RT: ____ ms | Std Dev: ____ ms
Comments:

H14 | Alexa: "set mode to away" | Phase H
Method: | พูด Alexa
Expected: Away cascade
# | Date | Time | Input/Command | Actual Output | RT (ms) | P/F | Notes

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
Pass Count: ___/10 | Pass Rate: ____% | Avg RT: ____ ms | Std Dev: ____ ms
Comments:

H15 | Alexa: "what is the bedroom temperature" | Phase H
Method: | พูด Alexa
Expected: TTS reply with °C
# | Date | Time | Input/Command | Actual Output | RT (ms) | P/F | Notes

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
Pass Count: ___/10 | Pass Rate: ____% | Avg RT: ____ ms | Std Dev: ____ ms
Comments:

H16 | Alexa: "activate party scene" | Phase H
Method: | พูด Alexa
Expected: Tuya colorloop
# | Date | Time | Input/Command | Actual Output | RT (ms) | P/F | Notes

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
Pass Count: ___/10 | Pass Rate: ____% | Avg RT: ____ ms | Std Dev: ____ ms
Comments:

H17 | Alexa: "lock the front door" | Phase H
Method: | พูด Alexa
Expected: lock + servo หมุน
# | Date | Time | Input/Command | Actual Output | RT (ms) | P/F | Notes

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
Pass Count: ___/10 | Pass Rate: ____% | Avg RT: ____ ms | Std Dev: ____ ms
Comments:

H18 | Alexa: "tell home control I am going to sleep" | Phase H
Method: | พูด Alexa
Expected: Sleep mode via AI Agent
# | Date | Time | Input/Command | Actual Output | RT (ms) | P/F | Notes

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
Pass Count: ___/10 | Pass Rate: ____% | Avg RT: ____ ms | Std Dev: ____ ms
Comments:

H19 | Alexa: "tell home control what model is the living room bulb" | Phase H
Method: | พูด Alexa
Expected: TTS "Tuya TS0505B"
# | Date | Time | Input/Command | Actual Output | RT (ms) | P/F | Notes

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
Pass Count: ___/10 | Pass Rate: ____% | Avg RT: ____ ms | Std Dev: ____ ms
Comments:

H20 | Alexa Thai bridge: "tell home control เปิดโหมดปาร์ตี้" | Phase H
Method: | พูด Alexa
Expected: Party scene via AI Agent (Thai)
# | Date | Time | Input/Command | Actual Output | RT (ms) | P/F | Notes

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
Pass Count: ___/10 | Pass Rate: ____% | Avg RT: ____ ms | Std Dev: ____ ms
Comments:

H21 | LINE Reasoning: "ทำอาหารปลอดภัยมั้ย" | Phase H
Method: | ส่ง LINE
Expected: เช็ค gas + เตา + suggest ไฟครัว
# | Date | Time | Input/Command | Actual Output | RT (ms) | P/F | Notes

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
Pass Count: ___/10 | Pass Rate: ____% | Avg RT: ____ ms | Std Dev: ____ ms
Comments:

H22 | LINE Reasoning: "หิวแต่กลัวก๊าซรั่ว" | Phase H
Method: | ส่ง LINE
Expected: scan gas | ยืนยันปลอดภัย
# | Date | Time | Input/Command | Actual Output | RT (ms) | P/F | Notes

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
Pass Count: ___/10 | Pass Rate: ____% | Avg RT: ____ ms | Std Dev: ____ ms
Comments:

H23 | LINE Reasoning: "บ้านดูยุ่งเหยิงจัง" | Phase H
Method: | ส่ง LINE
Expected: list device ON | propose ปิด
# | Date | Time | Input/Command | Actual Output | RT (ms) | P/F | Notes

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
Pass Count: ___/10 | Pass Rate: ____% | Avg RT: ____ ms | Std Dev: ____ ms
Comments:

H24 | LINE Reasoning: "ออกจากบ้าน ลืมอะไรมั้ย" | Phase H
Method: | ส่ง LINE
Expected: checklist เตรียม Away
# | Date | Time | Input/Command | Actual Output | RT (ms) | P/F | Notes

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
Pass Count: ___/10 | Pass Rate: ____% | Avg RT: ____ ms | Std Dev: ____ ms
Comments:

H25 | LINE Reasoning: "พรุ่งนี้ตื่นเช้า" | Phase H
Method: | ส่ง LINE
Expected: Sleep mode + suggest Sunrise scene
# | Date | Time | Input/Command | Actual Output | RT (ms) | P/F | Notes

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
Pass Count: ___/10 | Pass Rate: ____% | Avg RT: ____ ms | Std Dev: ____ ms
Comments:

H26 | LINE Reasoning: "หนาว" | Phase H
Method: | ส่ง LINE
Expected: อ่าน temp + ปิดพัดลม + Tuya warm
# | Date | Time | Input/Command | Actual Output | RT (ms) | P/F | Notes

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
Pass Count: ___/10 | Pass Rate: ____% | Avg RT: ____ ms | Std Dev: ____ ms
Comments:

H27 | LINE Reasoning: "มีคนกลับบ้านมั้ย" | Phase H
Method: | ส่ง LINE
Expected: check device_tracker + GPS + door history
# | Date | Time | Input/Command | Actual Output | RT (ms) | P/F | Notes

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
Pass Count: ___/10 | Pass Rate: ____% | Avg RT: ____ ms | Std Dev: ____ ms
Comments:

H28 | LINE Reasoning: "ดึกแล้ว" (ตอน 23:00+) | Phase H
Method: | ส่ง LINE
Expected: time-aware Sleep mode suggestion
# | Date | Time | Input/Command | Actual Output | RT (ms) | P/F | Notes

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
Pass Count: ___/10 | Pass Rate: ____% | Avg RT: ____ ms | Std Dev: ____ ms
Comments:

H29 | Alexa Reasoning: "is it safe to cook" | Phase H
Method: | พูด Alexa
Expected: gas check + stove + suggest light
# | Date | Time | Input/Command | Actual Output | RT (ms) | P/F | Notes

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
Pass Count: ___/10 | Pass Rate: ____% | Avg RT: ____ ms | Std Dev: ____ ms
Comments:

H30 | Alexa Reasoning: "I am cold" | Phase H
Method: | พูด Alexa
Expected: bedroom temp + adjust
# | Date | Time | Input/Command | Actual Output | RT (ms) | P/F | Notes

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
Pass Count: ___/10 | Pass Rate: ____% | Avg RT: ____ ms | Std Dev: ____ ms
Comments:

H31 | Alexa Reasoning: "turn off what I do not need" | Phase H
Method: | พูด Alexa
Expected: smart triage
# | Date | Time | Input/Command | Actual Output | RT (ms) | P/F | Notes

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
Pass Count: ___/10 | Pass Rate: ____% | Avg RT: ____ ms | Std Dev: ____ ms
Comments:

H32 | Alexa Reasoning: "what is wrong" (after alert) | Phase H
Method: | พูด Alexa
Expected: multi-sensor scan
# | Date | Time | Input/Command | Actual Output | RT (ms) | P/F | Notes

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
Pass Count: ___/10 | Pass Rate: ____% | Avg RT: ____ ms | Std Dev: ____ ms
Comments:

H33 | Alexa Reasoning: "help me sleep" | Phase H
Method: | พูด Alexa
Expected: multi-action sleep prep
# | Date | Time | Input/Command | Actual Output | RT (ms) | P/F | Notes

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
Pass Count: ___/10 | Pass Rate: ____% | Avg RT: ____ ms | Std Dev: ____ ms
Comments:

H34 | Alexa Reasoning: "good morning" | Phase H
Method: | พูด Alexa
Expected: weather + temp + Sunrise scene
# | Date | Time | Input/Command | Actual Output | RT (ms) | P/F | Notes

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
Pass Count: ___/10 | Pass Rate: ____% | Avg RT: ____ ms | Std Dev: ____ ms
Comments:

H35 | Alexa Reasoning: "did I forget anything" | Phase H
Method: | พูด Alexa
Expected: pre-Away checklist
# | Date | Time | Input/Command | Actual Output | RT (ms) | P/F | Notes

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
Pass Count: ___/10 | Pass Rate: ____% | Avg RT: ____ ms | Std Dev: ____ ms
Comments:

H36 | Alexa Reasoning: "what should I do now" | Phase H
Method: | พูด Alexa
Expected: time + state inference
# | Date | Time | Input/Command | Actual Output | RT (ms) | P/F | Notes

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
Pass Count: ___/10 | Pass Rate: ____% | Avg RT: ____ ms | Std Dev: ____ ms
Comments:

H37 | Multi-step LINE: "หิว" | reply | "ตกลง" | Phase H
Method: | ส่ง 2 turns
Expected: follow-through action
# | Date | Time | Input/Command | Actual Output | RT (ms) | P/F | Notes

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
Pass Count: ___/10 | Pass Rate: ____% | Avg RT: ____ ms | Std Dev: ____ ms
Comments:

H38 | Multi-step LINE: "ฉันจะทำอาหาร" | "เสร็จแล้ว" | Phase H
Method: | ส่ง 2 turns
Expected: mode/scene back to normal
# | Date | Time | Input/Command | Actual Output | RT (ms) | P/F | Notes

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
Pass Count: ___/10 | Pass Rate: ____% | Avg RT: ____ ms | Std Dev: ____ ms
Comments:

H39 | Compound Alexa: "I am leaving home but feed the dog first" | Phase H
Method: | พูด Alexa
Expected: break down: feed + Away
# | Date | Time | Input/Command | Actual Output | RT (ms) | P/F | Notes

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
Pass Count: ___/10 | Pass Rate: ____% | Avg RT: ____ ms | Std Dev: ____ ms
Comments:

## Phase I — Integration Tests

I01 | HA Dashboard Latency | Phase I
Method: | click switch on Lovelace, measure ms
Expected: < 500 ms
# | Date | Time | Input/Command | Actual Output | RT (ms) | P/F | Notes

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
Pass Count: ___/10 | Pass Rate: ____% | Avg RT: ____ ms | Std Dev: ____ ms
Comments:

I02 | Alexa Latency (same command) | Phase I
Method: | voice + measure
Expected: 1-3 seconds
# | Date | Time | Input/Command | Actual Output | RT (ms) | P/F | Notes

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
Pass Count: ___/10 | Pass Rate: ____% | Avg RT: ____ ms | Std Dev: ____ ms
Comments:

I03 | LINE Latency (same command) | Phase I
Method: | LINE + measure
Expected: 2-5 seconds (Claude API)
# | Date | Time | Input/Command | Actual Output | RT (ms) | P/F | Notes

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
Pass Count: ___/10 | Pass Rate: ____% | Avg RT: ____ ms | Std Dev: ____ ms
Comments:

I04 | Sleep mode + adaptive disabled | Phase I
Method: | Sleep + walk PIR
Expected: ไฟไม่เปิด (adaptive OFF)
# | Date | Time | Input/Command | Actual Output | RT (ms) | P/F | Notes

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
Pass Count: ___/10 | Pass Rate: ____% | Avg RT: ____ ms | Std Dev: ____ ms
Comments:

I05 | Sleep mode + path light fires | Phase I
Method: | Sleep + PIR bedroom
Expected: Tuya dim 10% warm
# | Date | Time | Input/Command | Actual Output | RT (ms) | P/F | Notes

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
Pass Count: ___/10 | Pass Rate: ____% | Avg RT: ____ ms | Std Dev: ____ ms
Comments:

I06 | Sleep path light auto-off 2 min | Phase I
Method: | after path light
Expected: auto OFF after 2 min
# | Date | Time | Input/Command | Actual Output | RT (ms) | P/F | Notes

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
Pass Count: ___/10 | Pass Rate: ____% | Avg RT: ____ ms | Std Dev: ____ ms
Comments:

I07 | Cascade conflict — rapid mode changes | Phase I
Method: | HomeSleepHomeSleepAway (5s)
Expected: final state correct, no stuck
# | Date | Time | Input/Command | Actual Output | RT (ms) | P/F | Notes

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
Pass Count: ___/10 | Pass Rate: ____% | Avg RT: ____ ms | Std Dev: ____ ms
Comments:

I08 | Away during adaptive | Phase I
Method: | Set Away while adaptive light ON
Expected: ไฟปิด, lock ทำงาน
# | Date | Time | Input/Command | Actual Output | RT (ms) | P/F | Notes

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
Pass Count: ___/10 | Pass Rate: ____% | Avg RT: ____ ms | Std Dev: ____ ms
Comments:

I09 | Sleep during Relax auto-fan | Phase I
Method: | Set Sleep while Relax fan ON
Expected: fan OFF, curtain close
# | Date | Time | Input/Command | Actual Output | RT (ms) | P/F | Notes

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
Pass Count: ___/10 | Pass Rate: ____% | Avg RT: ____ ms | Std Dev: ____ ms
Comments:

I10 | ESP32 reboot recovery | Phase I
Method: | unplug ESP32 #1 10s + plug
Expected: reconnect MQTT + retained state restore
# | Date | Time | Input/Command | Actual Output | RT (ms) | P/F | Notes

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
Pass Count: ___/10 | Pass Rate: ____% | Avg RT: ____ ms | Std Dev: ____ ms
Comments:

I11 | HA restart recovery | Phase I
Method: | restart HA container
Expected: all entities back online
# | Date | Time | Input/Command | Actual Output | RT (ms) | P/F | Notes

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
Pass Count: ___/10 | Pass Rate: ____% | Avg RT: ____ ms | Std Dev: ____ ms
Comments:

I12 | WiFi disconnect/reconnect | Phase I
Method: | disconnect 30s + reconnect
Expected: webhook auto-heal
# | Date | Time | Input/Command | Actual Output | RT (ms) | P/F | Notes

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
Pass Count: ___/10 | Pass Rate: ____% | Avg RT: ____ ms | Std Dev: ____ ms
Comments:
