Maradosx/smart-home-aiot/DEFENSE_HANDOFF/NETWORK_DATAFLOW_v2.pdf

◆

# BANGKOK

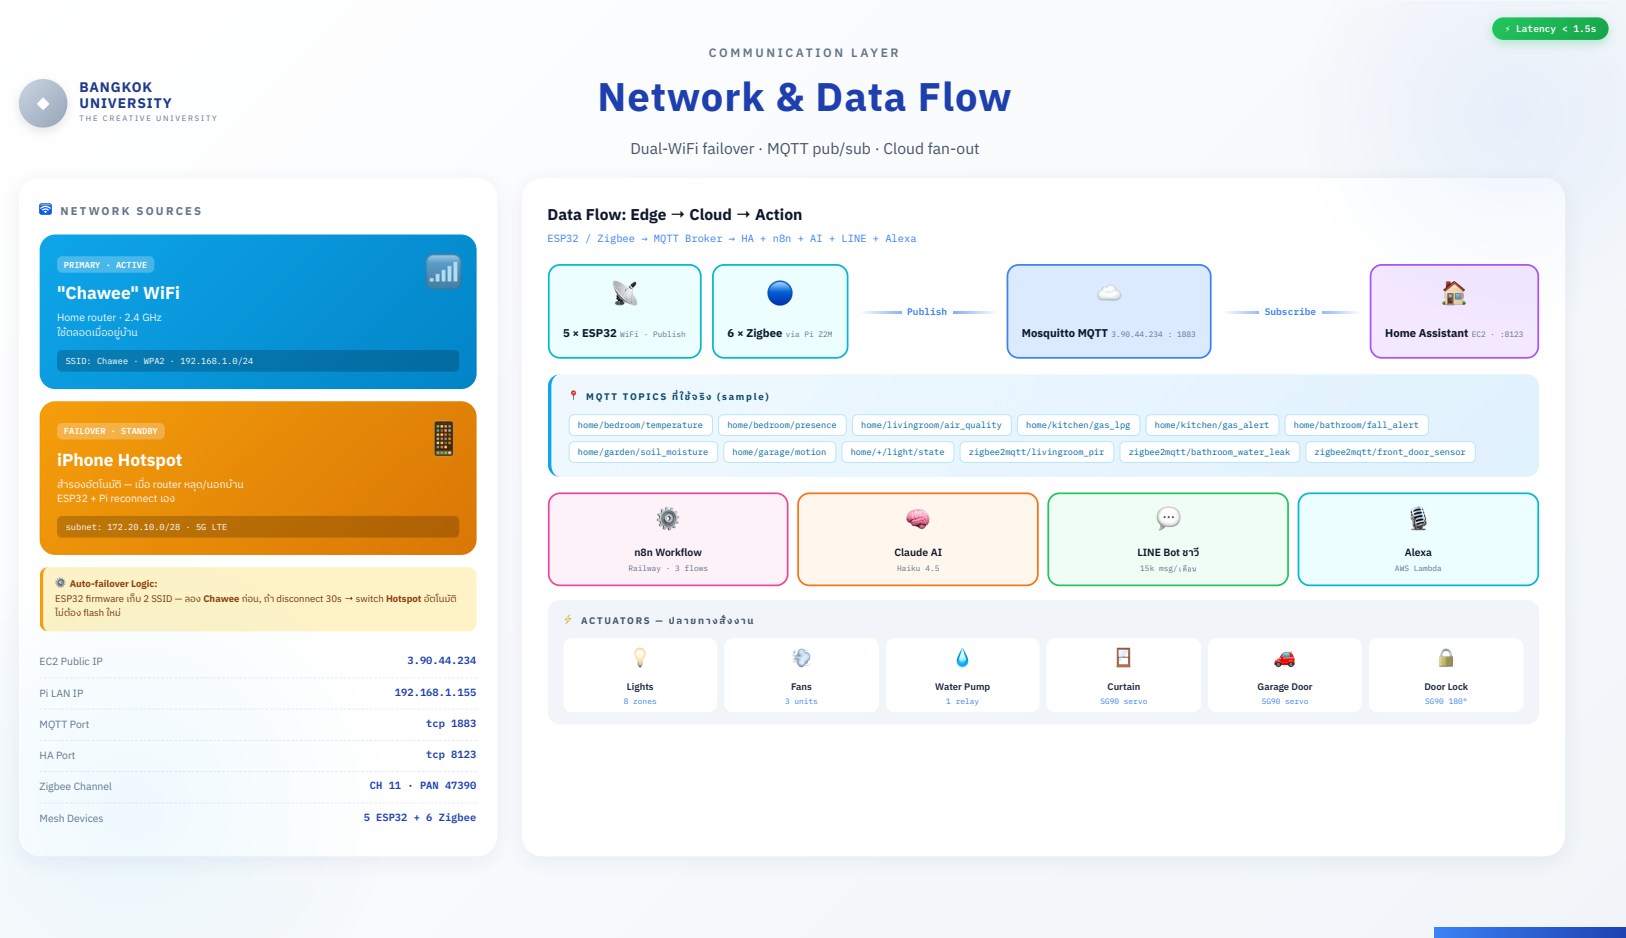
[picture p1: page 1]
UNIVERSITY; EC2 Public IP; Pi LAN IP; MQTT Port; tcp 1883; HA Port; tcp 8123; Zigbee Channel; CH 11 · PAN 47390; Mesh Devices; 5 ESP32 + 6 Zigbee; 5 × ESP32 WiFi · Publish; Mosquitto MQTT 3.90.44.234 : 1883; Home Assistant EC2 · :8123; home/bedroom/temperature; home/bedroom/presence; home/livingroom/air_quality; home/kitchen/gas_lpg; home/kitchen/gas_alert; home/bathroom/fall_alert; home/garden/soil_moisture; home/garage/motion; home/+/light/state; zigbee2mqtt/livingroom_pir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

Network & Data Flow

Dual-WiFi failover · MQTT pub/sub · Cloud fan-out

Data Flow: Edge → Cloud → Action

ESP32 / Zigbee → MQTT Broker → HA + n8n + AI + LINE + Alexa

PRIMARY · ACTIVE
"Chawee" WiFi
Home router · 2.4 GHz

6 × Zigbee via Pi Z2M

ESP32 + Pi reconnect เอง

LINE Bot ชาวี
15k msg/เดือน

⚙️ Auto-failover Logic:
ESP32 firmware เก็บ 2 SSID — ลอง Chawee ก่อน, ถ้า disconnect 30s → switch Hotspot อัตโนมัติ
ไม่ต้อง flash ใหม่
