Maradosx/smart-home-aiot/DEFENSE_HANDOFF/SOFTWARE_2slides_v2.pdf

## BANGKOK UNIVERSITY

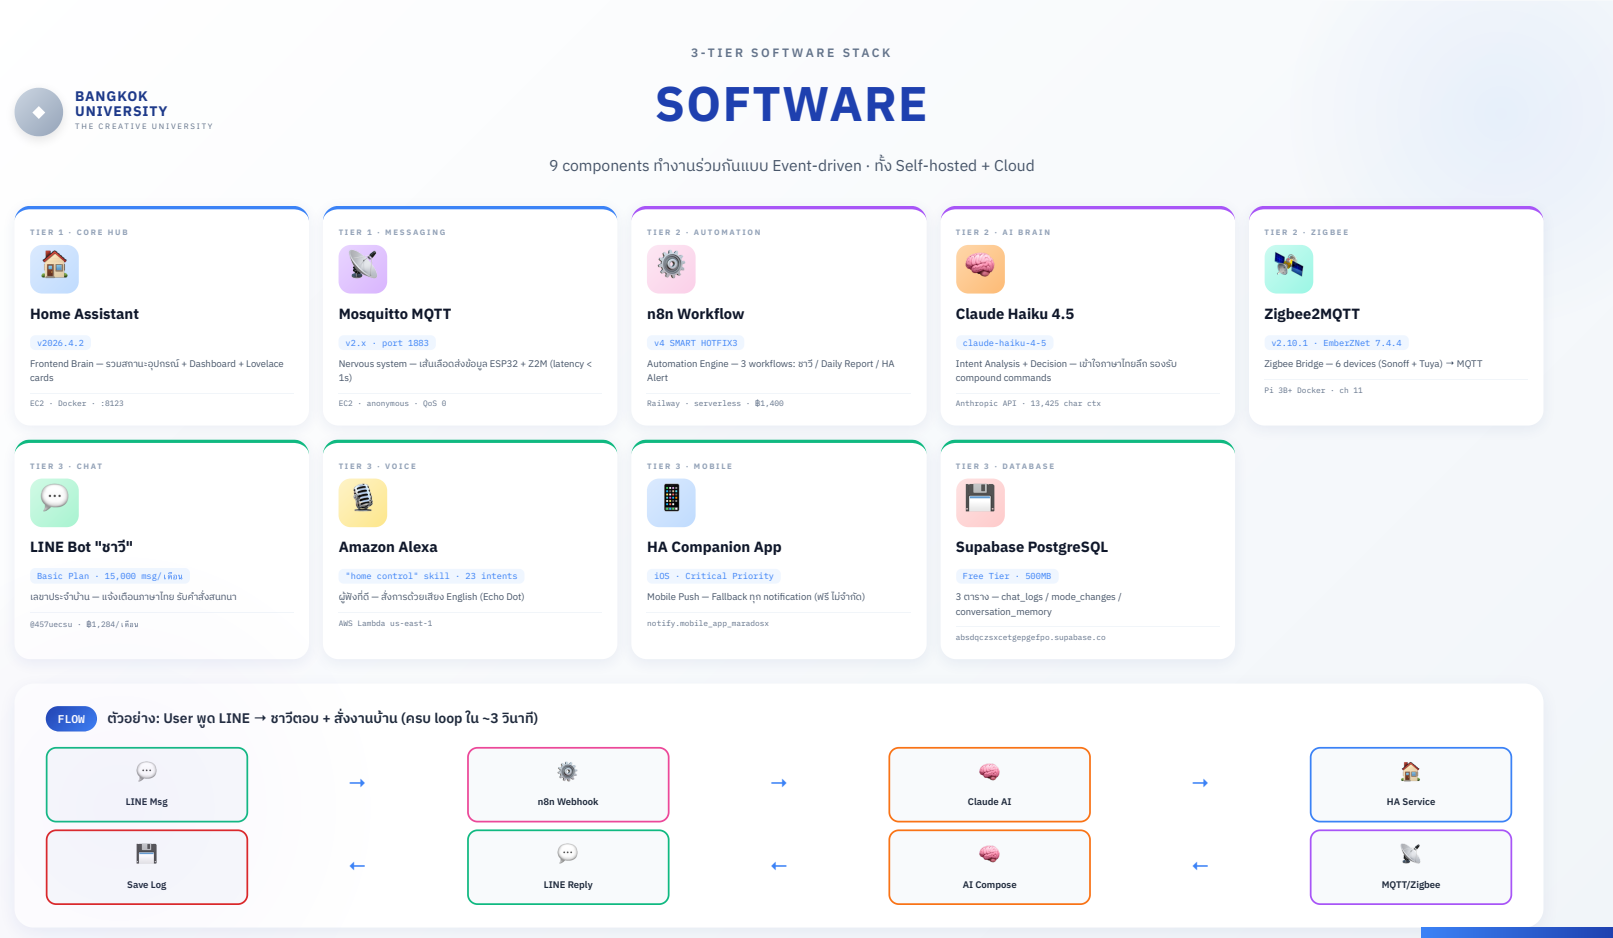
[picture p2: page 1]
3 - T I E R S O F T W A R E S TA C K SOFTWARE; FLOW; ตัวอย่าง: User พูด LINE → ชาวีตอบ + สั่งงานบ้าน (ครบ loop ใน ~3 วินาที); LINE Msg; n8n Webhook; Claude AI; HA Service; Save Log; LINE Reply; AI Compose; MQTT/Zigbee; Home Assistant; EC2 · Docker · :8123; Mosquitto MQTT; EC2 · anonymous · QoS 0; n8n Workflow; Railway · serverless · ฿1,400; Claude Haiku 4.5; Zigbee2MQTT; @457uecsu · ฿1,284/เดือน; Amazon Alexa; notify.mobile_app_maradosx; T I E R 3 · D ATA B A S E 💾; Supabase PostgreSQL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

9 components ทำ งานร่วมกันแบบ Event-driven · ทั้ง Self-hosted + Cloud

Frontend Brain — รวมสถานะอุปกรณ์ + Dashboard + Lovelace
cards

v2.x · port 1883
Nervous system — เส้นเลือดส่งข้อมูล ESP32 + Z2M (latency <

v4 SMART HOTFIX3
Automation Engine — 3 workflows: ชาวี / Daily Report / HA
Alert

claude-haiku-4-5
Intent Analysis + Decision — เข้าใจภาษาไทยลึก รองรับ
compound commands

v2.10.1 · EmberZNet 7.4.4
Zigbee Bridge — 6 devices (Sonoff + Tuya) → MQTT

Pi 3B+ Docker · ch 11

Anthropic API · 13,425 char ctx

LINE Bot "ชาวี"

HA Companion App

Basic Plan · 15,000 msg/เดือน
เลขาประจำ บ้าน — แจ้งเตือนภาษาไทย รับคำ สั่งสนทนา

"home control" skill · 23 intents
ผู้ฟังที่ดี — สั่งการด้วยเสียง English (Echo Dot)

iOS · Critical Priority
Mobile Push — Fallback ทุก notification (ฟรี ไม่จำ กัด)

AWS Lambda us-east-1

absdqczsxcetgepgefpo.supabase.co

## BANGKOK UNIVERSITY

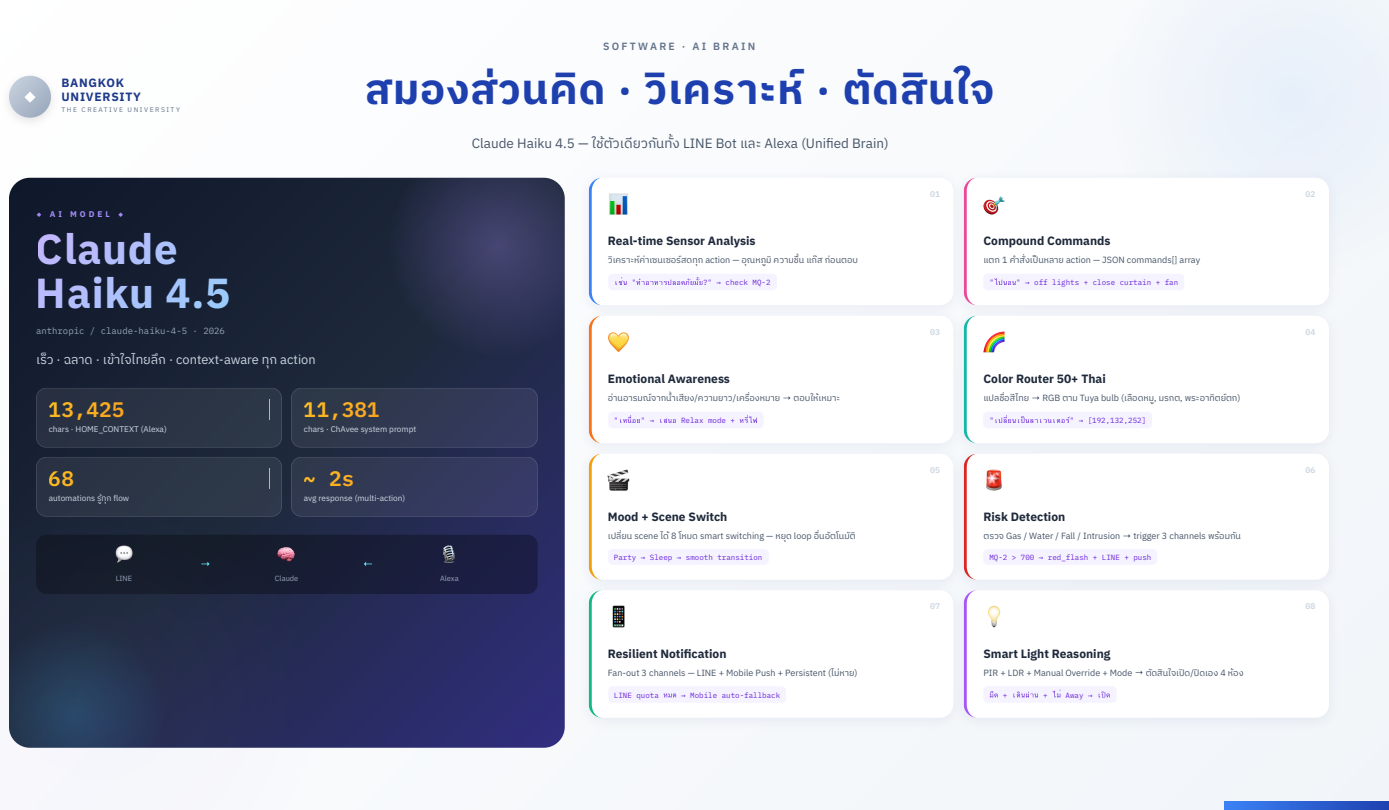
[picture p3: page 2]
◆ A I M O D E L ◆ Claude Haiku 4.5; LINE; Claude; Alexa; chars · HOME_CONTEXT (Alexa); automations; รู้ทุก flow; อาหารปลอดภัยมั้ย?" → check MQ-2; Away → เปิด

สมองส่วนคิด · วิเคราะห์ · ตัดสินใจ

Claude Haiku 4.5 — ใช้ตัวเดียวกันทั้ง LINE Bot และ Alexa (Unified Brain)

Real-time Sensor Analysis
วิเคราะห์ค่าเซนเซอร์สดทุก action — อุณหภูมิ ความชื้น แก๊ส ก่อนตอบ

Compound Commands
แตก 1 คำ สั่งเป็นหลาย action — JSON commands[] array

"ไปนอน" → off lights + close curtain + fan

anthropic / claude-haiku-4-5 · 2026
เร็ว · ฉลาด · เข้าใจไทยลึก · context-aware ทุก action

Emotional Awareness
อ่านอารมณ์จากน้ำ เสียง/ความยาว/เครื่องหมาย → ตอบให้เหมาะ

Color Router 50+ Thai
แปลชื่อสีไทย → RGB ตาม Tuya bulb (เลือดหมู, มรกต, พระอาทิตย์ตก)

"เหนื่อย" → เสนอ Relax mode + หรี่ไฟ

"เปลี่ยนเป็นลาเวนเดอร์" → [192,132,252]

chars · ChAvee system prompt

avg response (multi-action)

Mood + Scene Switch
เปลี่ยน scene ได้ 8 โหมด smart switching — หยุด loop อื่นอัตโนมัติ

Risk Detection
ตรวจ Gas / Water / Fall / Intrusion → trigger 3 channels พร้อมกัน

Party → Sleep → smooth transition

MQ-2 > 700 → red_flash + LINE + push

Resilient Notification
Fan-out 3 channels — LINE + Mobile Push + Persistent (ไม่หาย)

Smart Light Reasoning
PIR + LDR + Manual Override + Mode → ตัดสินใจเปิด/ปิดเอง 4 ห้อง

LINE quota หมด → Mobile auto-fallback
