Maradosx/smart-home-aiot/DEFENSE_HANDOFF/WORKFLOWS_3slides_v2.pdf

# BANGKOK UNIVERSITY

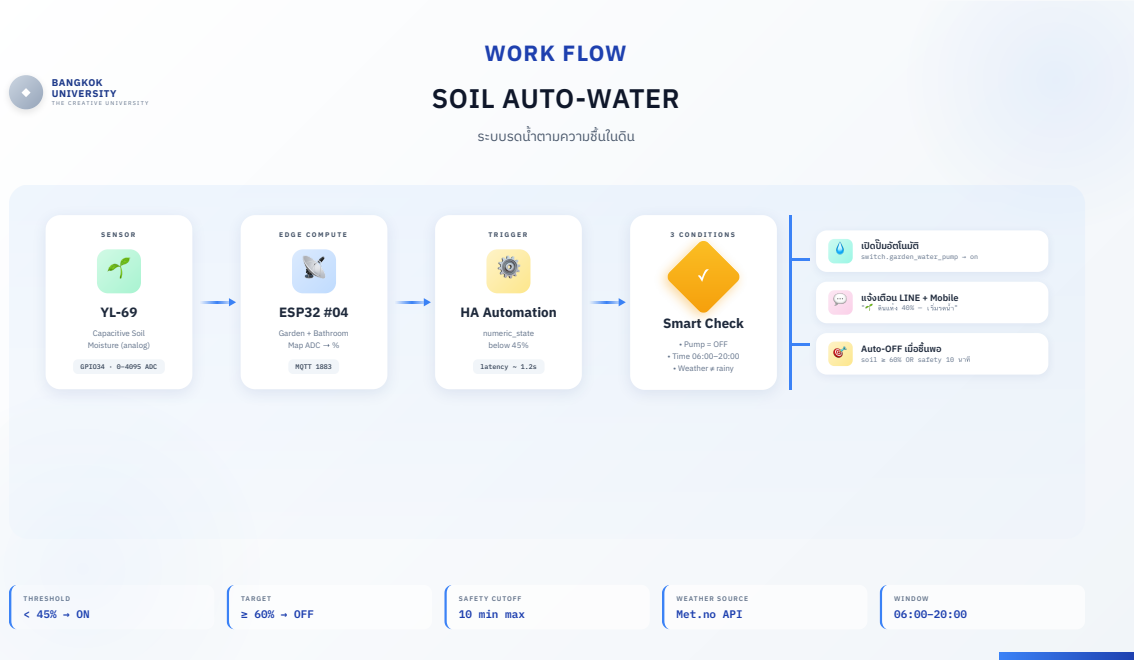
[picture p4: page 1]
เปิดปั๊มอัตโนมัติ; switch.garden_water_pump → on; แจ้งเตือน LINE + Mobile; "🌱 ดินแห้ง 40% — เริ่มรดน้ำ; Auto-OFF เมื่อชื้นพอ; Capacitive Soil Moisture (analog); GPIO34 · 0–4095 ADC; ESP32 #04; Garden + Bathroom Map ADC → %; MQTT 1883; HA Automation; numeric_state below 45%; latency ~ 1.2s; Smart Check; • Pump = OFF • Time 06:00–20:00 • Weather ≠ rainy; THRESHOLD < 45% → ON; TARGET ≥ 60% → OFF; SAFETY CUTOFF 10 min max; WINDOW 06:00–20:00

WORK FLOW
SOIL AUTO-WATER

ระบบรดน้ำ ตามความชื้นในดิน

soil ≥ 60% OR safety 10 นาที

WEATHER SOURCE
Met.no API

# BANGKOK UNIVERSITY

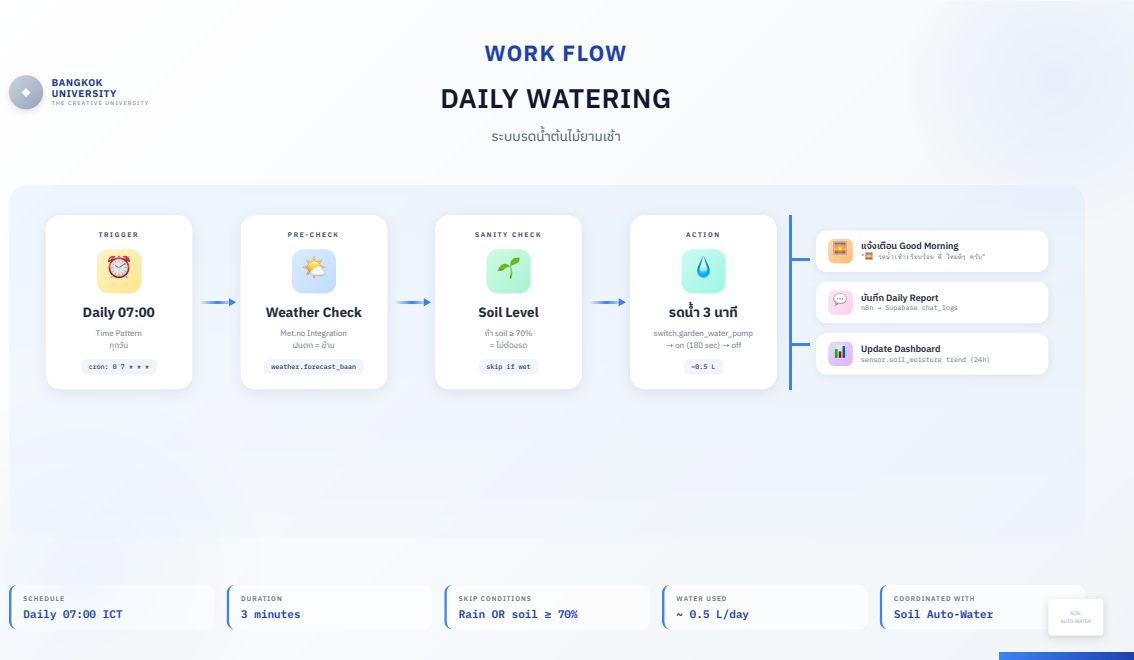
[picture p5: page 2]
WORK FLOW DAILY WATERING; แจ้งเตือน Good Morning; "🌅 รดน้ำ; เช้าเรียบร้อย ดี; ใหม่ดีๆ ครับ"; บันทึก Daily Report; n8n → Supabase chat_logs; Update Dashboard; sensor.soil_moisture trend (24h); Daily 07:00; Time Pattern; cron: 0 7 * * *; Weather Check; weather.forecast_baan; Soil Level; ถ้า soil ≥ 70% = ไม่ต้องรด; รดน้ำ; 3 นาที; SCHEDULE Daily 07:00 ICT; DURATION 3 minutes; WATER USED ~ 0.5 L/day; COORDINATED WITH; Soil Auto-Water; SOIL; AUTO-WATER

ระบบรดน้ำ ต้นไม้ยามเช้า

Met.no Integration
ฝนตก = ข้าม

switch.garden_water_pump
→ on (180 sec) → off

skip if wet

SKIP CONDITIONS
Rain OR soil ≥ 70%

# BANGKOK UNIVERSITY

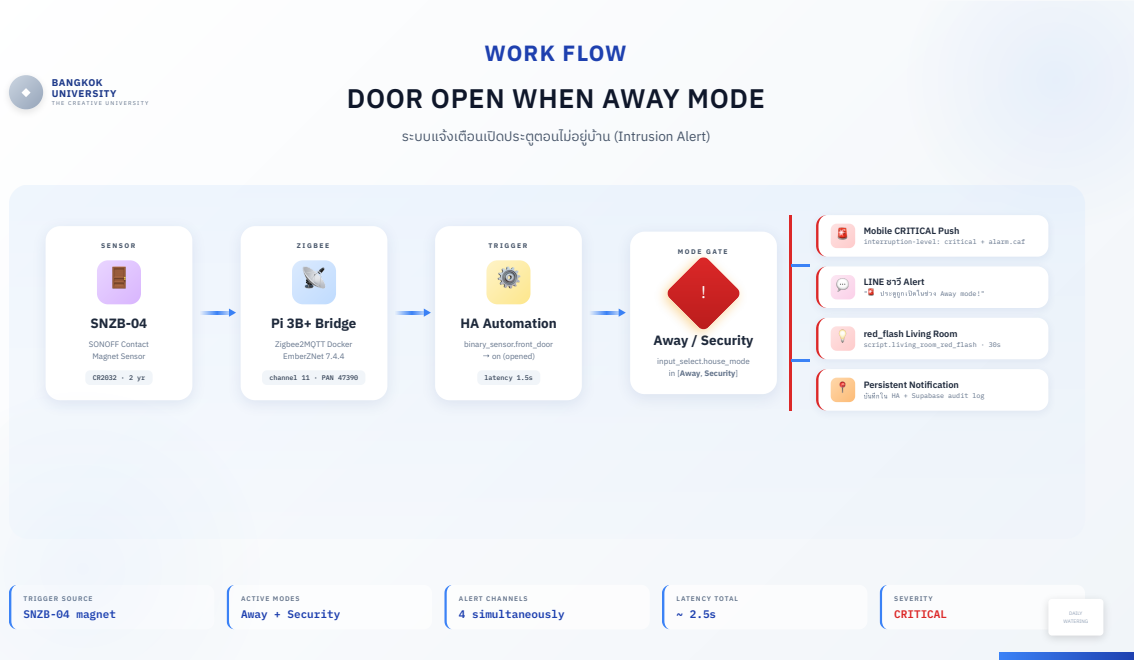
[picture p6: page 3]
WORK FLOW; Mobile CRITICAL Push; LINE ชาวี Alert; red_flash Living Room; script.living_room_red_flash · 30s; Persistent Notification; SNZB-04; SONOFF Contact Magnet Sensor; Pi 3B+ Bridge; Zigbee2MQTT Docker EmberZNet 7.4.4; channel 11 · PAN 47390; HA Automation; binary_sensor.front_door → on (opened); latency 1.5s; Away / Security; TRIGGER SOURCE SNZB-04 magnet; ACTIVE M ODES Away + Security; ALERT CHANNELS 4 simultaneously; LATENCY TOTAL ~ 2.5s; SEVERITY; CRITICAL; DAILY; WATERING

DOOR OPEN WHEN AWAY MODE

ระบบแจ้งเตือนเปิดประตูตอนไม่อยู่บ้าน (Intrusion Alert)

interruption-level: critical + alarm.caf

"🚨 ประตูถูกเปิดในช่วง Away mode!"

input_select.house_mode
in [Away, Security]

บันทึกใน HA + Supabase audit log
