Maradosx/smart-home-aiot/DEFENSE_HANDOFF/MOOD_SCENES_LIGHT_EFFECTS_v2.pdf

## BANGKOK UNIVERSITY

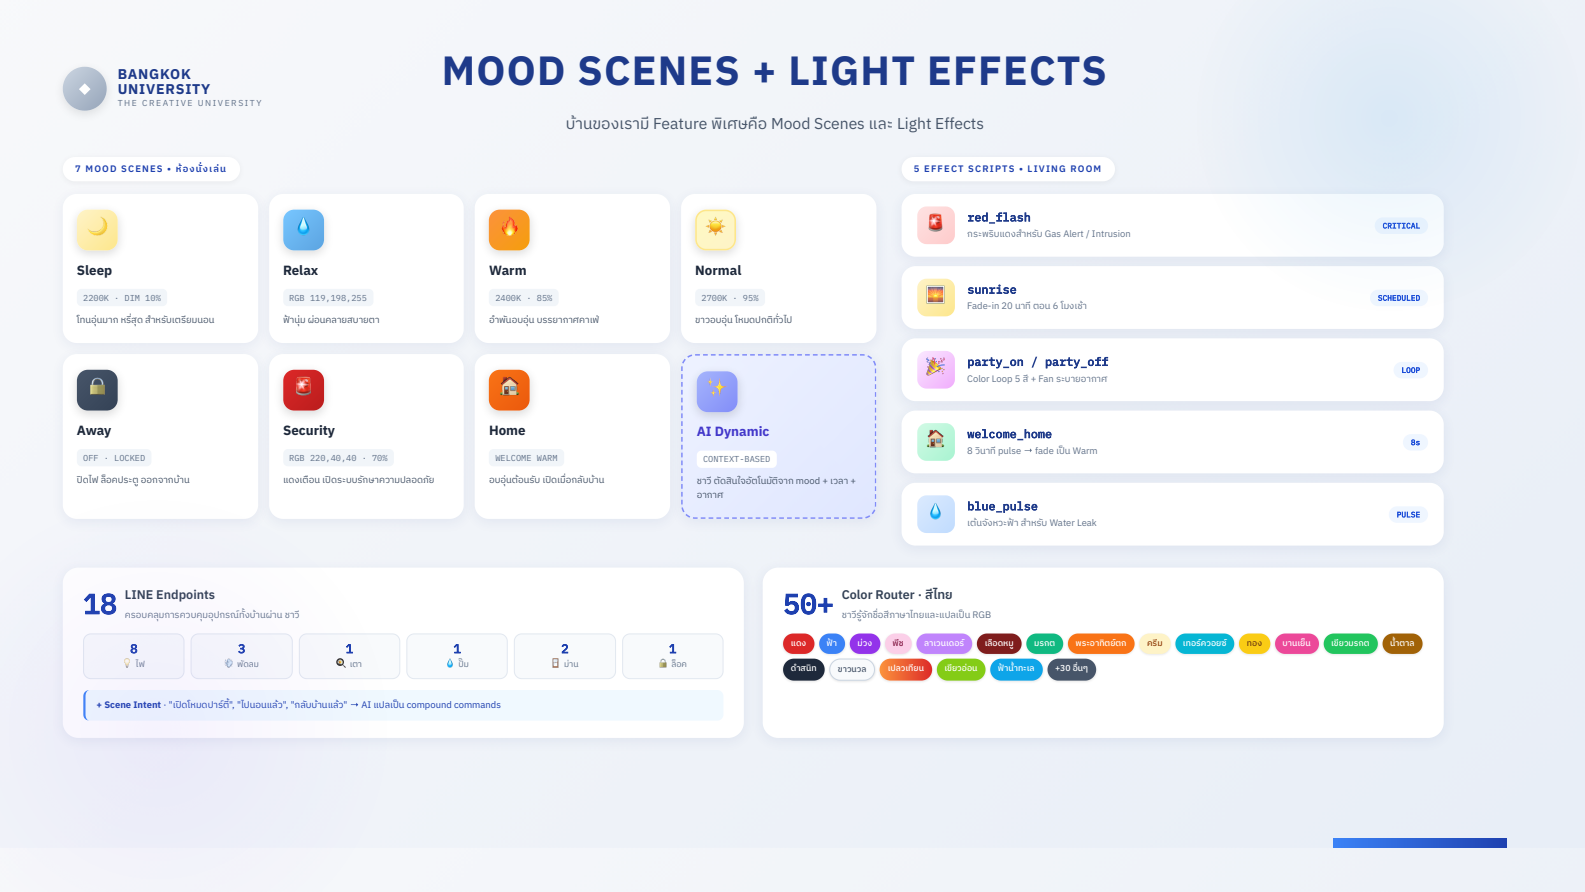
[picture p7: page 1]
7 MOOD SCENES • ห้องนั่งเล่น; 5 EFFECT SCRIPTS • LIVING ROOM; CRITICAL; SCHEDULED; party_on / party_off Color Loop 5 สี + Fan ระบายอากาศ; LOOP; PULSE; Sleep; Relax; RGB 119,198,255 ฟ้านุ่ม ผ่อนคลายสบายตา; Warm; Normal; Away; Security; Home; AI Dynamic

MOOD SCENES + LIGHT EFFECTS

บ้านของเรามี Feature พิเศษคือ Mood Scenes และ Light Effects

red_flash
กระพริบแดงสำ หรับ Gas Alert / Intrusion

sunrise
Fade-in 20 นาที ตอน 6 โมงเช้า

2200K · DIM 10%
โทนอุ่นมาก หรี่สุด สำ หรับเตรียมนอน

อำ พันอบอุ่น บรรยากาศคาเฟ่

ขาวอบอุ่น โหมดปกติทั่วไป

welcome_home
8 วินาที pulse → fade เป็น Warm

OFF · LOCKED
ปิดไฟ ล็อคประตู ออกจากบ้าน

RGB 220,40,40 · 70%
แดงเตือน เปิดระบบรักษาความปลอดภัย

WELCOME WARM
อบอุ่นต้อนรับ เปิดเมื่อกลับบ้าน

CONTEXT-BASED
ชาวี ตัดสินใจอัตโนมัติจาก mood + เวลา +
อากาศ

blue_pulse
เต้นจังหวะฟ้า สำ หรับ Water Leak

LINE Endpoints 18 ครอบคลุมการควบคุมอุปกรณ์ทั้งบ้านผ่าน ชาวี 8 3 1 💡 ไฟ 💨 พัดลม 🍳 เตา | 1 2 1 💧 ปั๊ม 🪟 ม่าน 🔒 ล็อค | | 50+

Color Router · สีไทย
ชาวีรู้จักชื่อสีภาษาไทยและแปลเป็น RGB

แดง | ฟ้า | ม่วง | พีช | ลาเวนเดอร์ | เลือดหมู | มรกต | พระอาทิตย์ตก | ครีม | เทอร์ควอยซ์ | ทอง | บานเย็น | เขียวมรกต | น้ำ ตาล
ดำ สนิท | ขาวนวล | เปลวเทียน | เขียวอ่อน | ฟ้าน้ำ ทะเล | +30 อื่นๆ

+ Scene Intent · "เปิดโหมดปาร์ตี้", "ไปนอนแล้ว", "กลับบ้านแล้ว" → AI แปลเป็น compound commands
