Maradosx/smart-home-aiot/(commit log)

2026-06-03 Smart Home AIoT — context-aware bilingual smart-home system
    Senior project (Computer & Robotics Engineering) — passed defense May 2026.
    A production smart home running 24/7 in a real house, controllable in Thai
    via a LINE bot ("ชาวี") and in English via Amazon Alexa, with an Anthropic
    Claude AI brain that interprets commands using live home context
    (GPS, time, weather, sensors, device states, modes).
    Architecture:
    - Edge: 5x ESP32 (DHT22, PIR, LDR, MQ-2 gas, LD2410 mmWave, soil, relays, servos)
    - Zigbee: Raspberry Pi 3B+ coordinator (Zigbee2MQTT) + 6 Sonoff/Tuya devices
    - Core: Home Assistant + Mosquitto MQTT on AWS EC2 (Docker)
    - AI: Anthropic Claude Haiku 4.5 (shared brain for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
2026-06-12 docs: lock HA counts to live-verified numbers (235 entities / 71 automations, 65 active / 7 scripts — verified via HA API 12 Jun 2026)
2026-06-22 feat: ChAvee multi-action + conversation memory; behavioral-reasonableness audit
    ChAvee AI:
    - Support multiple HA actions per request (haActions array) — "turn on the light and fan"
    - Inject recent conversation history from Supabase chat_logs for contextual follow-ups
    - Add reset_normal kill-switch scene (stop party/alert loops + restore warm light)
    Lighting:
    - Per-room manual override (30-min auto-clear) so manually turning a light off is respected
    - Sleep-mode guard on smart-light auto-on (no re-trigger while sleeping)
    - Resolve comfort-mode light scene conflict (single source of truth)
    Safety / modes:
    - Auto-close garage + auto-lock front door on Away; lock on Security
    - Turn off gard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
    [automations.yaml, configuration.yaml, lambda_function.py]
2026-06-23 fix(watering): 07:00 daily watering now skips wet soil (<50%) + rainy days
    The fixed-time 07:00 watering previously ran regardless of soil moisture or
    weather, over-watering already-wet soil and emitting redundant notifications.
    Add soil-moisture (<50%) + not-raining conditions and drop the duplicate
    pump-done alert. Works alongside the sensor-based smart pump. Daily Sunrise
    remains at 06:00 (Home mode).
    [configuration.yaml]
2026-06-23 fix(alerts): de-duplicate safety notifications (gas/leak/fall)
    The mobile "all-channels" automations were sending BOTH a mobile push AND a
    LINE alert, while the dedicated config automations already sent the LINE alert
    for the same sensor trigger — resulting in 2x LINE per gas/water-leak/fall event.
    Drop the redundant rest_command.send_alert from the mobile automations so each
    event yields exactly one LINE + one mobile push (two channels, no duplicate).
    [automations.yaml]
